jb69/WaveHat/hardware/netlist-revB.md

# WaveHat rev B: netlist

Generated by `kicad-revB/gen_docs.py` from `kicad-revB/wavehat_design.py`, the same file the schematic and PCB are built from. Don't edit by hand.

Pin numbers: LSM6DSO from ST AN5192; TPS560430 from TI SLVSE22B; XIAO pads 1-14 from Seeed's OPL KiCad library (identical on the C3, C6 and S3). CAN pins and the 0x6B address follow the Takuma project's XIAO node.

| Net | Class | Connects |
|---|---|---|
| `GND` | pour | C1.2, C2.2, C3.2, C4.2, C5.2, C7.2, C8.2, C9.2, H1.1, H2.1, J2.1 (Pin_1), J3.1 (Pin_1), J4.3 (Pin_3), J5.6 (Pin_6), J6.3 (Pin_3), J6.10 (Pin_10), J7.2 (Pin_2), JP3.3 (B), R4.2, R6.2, TP11.1, TP25.1, TVS1.2 (A), U1.2 (SDx), U1.3 (SCx), U1.6 (GND), U1.7 (GND), U2.2 (GND), U3.2 (GND), U4.13 (GND), U4.16 (GND(C3/S3)), U4.18 (GND(C6)), U5.4 (VSS) |
| `5V_BUCK` | Power | C5.1, D2.2 (A), L1.2, R3.1, TP22.1 |
| `5V_CAN` | Power | D3.2 (A), J3.4 (Pin_4), TP19.1 |
| `SW` | Power | C6.2, L1.1, U2.6 (SW) |
| `VBAT` | Power | J7.1 (Pin_1), U4.15 (VBAT(C3/S3)), U4.17 (VBAT(C6)) |
| `VIN` | Power | C4.1, D1.1 (K), TP21.1, TVS1.1 (K), U2.4 (EN), U2.5 (VIN) |
| `VIN_FUSED` | Power | D1.2 (A), F1.2 |
| `VIN_RAW` | Power | F1.1, J4.2 (Pin_2), TP20.1 |
| `XIAO_5V` | Power | D2.1 (K), D3.1 (K), J5.1 (Pin_1), J6.1 (Pin_1), TP23.1, U4.14 (5V) |
| `3V3` | Supply 0.3 mm | C1.1, C2.1, C3.1, C8.1, C9.1, J2.2 (Pin_2), J6.2 (Pin_2), JP3.1 (A), JP8.1 (A), R1.1, R10.1, R11.1, R12.1, R2.1, R9.1, TP26.1, TP8.1, U1.5 (VDDIO), U1.8 (VDD), U1.12 (CS), U4.12 (3V3), U5.8 (VCC) |
| `3V3_CAN` | Supply 0.3 mm | C7.1, JP8.2 (B), U3.3 (VCC) |
| `CANH` | signal | J3.3 (Pin_3), J4.4 (Pin_4), R5.1, TP14.1, U3.7 (CANH) |
| `CANL` | signal | J3.2 (Pin_2), J4.5 (Pin_5), JP6.2 (B), TP15.1, U3.6 (CANL) |
| `CAN_RX` | signal | J6.8 (Pin_8), JP9.1 (A), TP17.1, U4.1 (D0) |
| `CAN_RXD` | signal | JP9.2 (B), U3.4 (R) |
| `CAN_TX` | signal | J6.9 (Pin_9), JP10.1 (A), TP16.1, U4.2 (D1) |
| `CAN_TXD` | signal | JP10.2 (B), U3.1 (D) |
| `CB` | signal | C6.1, TP24.1, U2.1 (CB) |
| `FB` | signal | R3.2, R4.1, U2.3 (FB) |
| `IMU_INT1` | signal | JP4.1 (A), TP9.1, U1.4 (INT1) |
| `IMU_INT2` | signal | JP5.1 (A), TP10.1, U1.9 (INT2) |
| `LED_B` | signal | J6.5 (Pin_5), JP5.2 (B), JP7.1 (A), TP2.1, U4.4 (D3) |
| `LED_R` | signal | J6.4 (Pin_4), JP4.2 (B), TP1.1, U4.3 (D2) |
| `RS` | signal | R6.1, U3.8 (Rs) |
| `SA0` | signal | JP3.2 (C), TP7.1, U1.1 (SDO/SA0) |
| `SCL` | signal | J2.4 (Pin_4), J5.4 (Pin_4), JP2.1 (A), TP4.1, U1.13 (SCL), U4.6 (D5/SCL) |
| `SCL_PU` | signal | JP2.2 (B), R2.2, TP6.1 |
| `SDA` | signal | J2.3 (Pin_3), J5.5 (Pin_5), JP1.1 (A), TP3.1, U1.14 (SDA), U4.5 (D4/SDA) |
| `SDA_PU` | signal | JP1.2 (B), R1.2, TP5.1 |
| `SD_CS` | signal | JP7.2 (B), R9.2, TP27.1, U5.2 (~{CS}) |
| `SD_MISO` | signal | R11.2, TP29.1, U4.10 (D9), U5.6 (DO) |
| `SD_MOSI` | signal | R12.2, TP30.1, U4.11 (D10), U5.5 (DI) |
| `SD_SCK` | signal | R10.2, TP28.1, U4.9 (D8), U5.3 (SCLK) |
| `TERM` | signal | JP6.1 (A), R5.2, TP18.1 |
| `UART_RX` | signal | J5.3 (Pin_3), J6.7 (Pin_7), TP13.1, U4.8 (D7/RX) |
| `UART_TX` | signal | J5.2 (Pin_2), J6.6 (Pin_6), TP12.1, U4.7 (D6/TX) |

**No connect:** J4.1 (Pin_1), U1.10 (OCS_Aux), U1.11 (SDO_Aux), U3.5 (Vref), U5.1 (RSV), U5.7 (RSV)

**Mechanical:** connector MP tabs unconnected; H1/H2 on GND; FID1-3 no net.

**Bottom side, bare copper (not assembled):** JP1-JP10 solder jumpers (JP8-JP10 isolate the CAN transceiver: cut all three for a build with no CAN), TP1-TP30 test pads (`kicad-revB/reports/test-pads.md`), J4 NMEA 2000 / 5-30 V pads. **DNP:** J5 GNSS port, J7 battery holes (U4 pads 15-18 are the carrier pads under the XIAO's own battery pads).
