jb69/WaveHat/hardware/netlist.md

# WaveHat rev A: netlist

Generated by `kicad/gen_docs.py` from `kicad/wavehat_design.py`, the same file the schematic and PCB are built from. Don't edit by hand.

Pin numbers: LSM6DSO from ST AN5192; TPS560430 from TI SLVSE22B; XIAO pads 1-14 from Seeed's OPL KiCad library (identical on the C3, C6 and S3). CAN pins and the 0x6B address follow the Takuma project's XIAO node.

| Net | Class | Connects |
|---|---|---|
| `GND` | pour | C1.2, C2.2, C3.2, C4.2, C5.2, C7.2, C8.2, C9.2, H1.1, H2.1, J2.1 (Pin_1), J3.1 (Pin_1), J4.3 (Pin_3), JP3.3 (B), R4.2, R6.2, TVS1.2 (A), U1.2 (SDx), U1.3 (SCx), U1.6 (GND), U1.7 (GND), U2.2 (GND), U3.2 (GND), U4.13 (GND), U5.4 (VSS) |
| `5V_BUCK` | Power | C5.1, D2.2 (A), L1.2, R3.1 |
| `5V_CAN` | Power | D3.2 (A), J3.4 (Pin_4) |
| `SW` | Power | C6.2, L1.1, U2.6 (SW) |
| `VIN` | Power | C4.1, D1.1 (K), TVS1.1 (K), U2.4 (EN), U2.5 (VIN) |
| `VIN_FUSED` | Power | D1.2 (A), F1.2 |
| `VIN_RAW` | Power | F1.1, J4.2 (Pin_2) |
| `XIAO_5V` | Power | D2.1 (K), D3.1 (K), U4.14 (5V) |
| `3V3` | signal | C1.1, C2.1, C3.1, C7.1, C8.1, C9.1, J2.2 (Pin_2), JP3.1 (A), R1.1, R10.1, R11.1, R12.1, R2.1, R9.1, U1.5 (VDDIO), U1.8 (VDD), U1.12 (CS), U3.3 (VCC), U4.12 (3V3), U5.8 (VCC) |
| `CANH` | signal | J3.3 (Pin_3), J4.4 (Pin_4), R5.1, U3.7 (CANH) |
| `CANL` | signal | J3.2 (Pin_2), J4.5 (Pin_5), JP6.2 (B), U3.6 (CANL) |
| `CAN_RX` | signal | U3.4 (R), U4.1 (D0) |
| `CAN_TX` | signal | U3.1 (D), U4.2 (D1) |
| `CB` | signal | C6.1, U2.1 (CB) |
| `FB` | signal | R3.2, R4.1, U2.3 (FB) |
| `IMU_INT1` | signal | JP4.1 (A), U1.4 (INT1) |
| `IMU_INT2` | signal | JP5.1 (A), U1.9 (INT2) |
| `LED_B` | signal | JP5.2 (B), JP7.1 (A), TP2.1, U4.4 (D3) |
| `LED_R` | signal | JP4.2 (B), TP1.1, U4.3 (D2) |
| `RS` | signal | R6.1, U3.8 (Rs) |
| `SA0` | signal | JP3.2 (C), U1.1 (SDO/SA0) |
| `SCL` | signal | J2.4 (Pin_4), JP2.1 (A), U1.13 (SCL), U4.6 (D5/SCL) |
| `SCL_PU` | signal | JP2.2 (B), R2.2 |
| `SDA` | signal | J2.3 (Pin_3), JP1.1 (A), U1.14 (SDA), U4.5 (D4/SDA) |
| `SDA_PU` | signal | JP1.2 (B), R1.2 |
| `SD_CS` | signal | JP7.2 (B), R9.2, U5.2 (~{CS}) |
| `SD_MISO` | signal | R11.2, U4.10 (D9), U5.6 (DO) |
| `SD_MOSI` | signal | R12.2, U4.11 (D10), U5.5 (DI) |
| `SD_SCK` | signal | R10.2, U4.9 (D8), U5.3 (SCLK) |
| `TERM` | signal | JP6.1 (A), R5.2 |

**No connect:** J4.1 (Pin_1), U1.10 (OCS_Aux), U1.11 (SDO_Aux), U3.5 (Vref), U4.7 (D6/TX), U4.8 (D7/RX), U5.1 (RSV), U5.7 (RSV)

**Mechanical:** connector MP tabs unconnected; H1/H2 on GND; FID1-3 no net.

**Bottom side, bare copper (not assembled):** JP1-JP6 solder jumpers, TP1-TP3 test pads, J4 NMEA 2000 / 12 V pads.
