jb69/WaveHat/hardware/kicad-revB/reports/vias.md

# Vias in rev B

Generated by `gen_pcb.py import`. 102 signal and power vias from the router, 43 of them twinned (a second via 0.8-2.0 mm away, linked on both layers); 59 found no room and stay single, so those crossings are the ones to meter first (`reports/test-pads.md` has the pads). GND stitching vias are not listed. Coordinates: mm from the board's lower-left corner, component side up, the Gerber origin.

| Net | Vias (x, y) | Twins | Single |
|---|---|---|---|
| 3V3 | (4.11, 6.91), (4.46, 44.26), (11.49, 67.13), (12.60, 64.82), (14.55, 57.30) | 3 | (14.55, 57.30), (4.46, 44.26) |
| 3V3_CAN | (7.71, 49.24) | 1 | - |
| 5V_BUCK | (5.86, 20.52), (17.65, 24.96) | 1 | (5.86, 20.52) |
| 5V_CAN | (13.90, 24.91), (17.10, 56.84) | 1 | (17.10, 56.84) |
| CANH | (7.50, 52.26), (7.72, 38.03), (8.14, 39.90), (9.87, 48.72), (12.89, 39.68) | 1 | (8.14, 39.90), (12.89, 39.68), (7.50, 52.26), (9.87, 48.72) |
| CANL | (5.07, 41.10), (5.20, 29.78), (5.24, 44.17), (6.33, 30.70), (11.49, 48.63) | 1 | (5.20, 29.78), (5.07, 41.10), (5.24, 44.17), (11.49, 48.63) |
| CAN_RX | (7.79, 45.30), (8.03, 24.74) | 1 | (7.79, 45.30) |
| CAN_RXD | (12.41, 47.16) | 1 | - |
| CAN_TX | (7.04, 43.76), (10.99, 30.19), (11.75, 25.38), (12.51, 33.98) | 1 | (7.04, 43.76), (10.99, 30.19), (12.51, 33.98) |
| CAN_TXD | (7.82, 44.53) | 0 | (7.82, 44.53) |
| CB | (4.44, 18.71) | 0 | (4.44, 18.71) |
| FB | (12.86, 30.27), (15.68, 31.74) | 0 | (12.86, 30.27), (15.68, 31.74) |
| IMU_INT1 | (8.14, 61.94), (9.34, 64.20), (13.09, 52.01), (13.26, 57.59), (13.55, 50.15) | 2 | (13.55, 50.15), (13.26, 57.59), (13.09, 52.01) |
| IMU_INT2 | (15.59, 60.27), (15.59, 62.99), (17.54, 58.24), (17.87, 48.40), (17.92, 44.24), (20.17, 64.15) | 4 | (15.59, 60.27), (17.87, 48.40) |
| LED_B | (4.20, 19.76), (6.42, 52.11), (8.92, 51.89), (14.27, 37.89), (14.49, 41.52), (16.33, 23.07), (17.08, 11.79) | 3 | (4.20, 19.76), (16.33, 23.07), (14.49, 41.52), (8.92, 51.89) |
| LED_R | (7.05, 42.99), (15.54, 38.45), (15.76, 24.58), (17.32, 31.04) | 0 | (7.05, 42.99), (15.76, 24.58), (17.32, 31.04), (15.54, 38.45) |
| RS | (10.49, 39.16), (12.19, 39.17) | 0 | (12.19, 39.17), (10.49, 39.16) |
| SA0 | (8.60, 67.03), (15.04, 65.34), (15.21, 58.86) | 3 | - |
| SCL | (2.15, 57.01), (4.08, 37.75), (4.76, 60.11), (10.50, 67.30), (16.96, 19.60), (19.67, 58.24) | 3 | (10.50, 67.30), (19.67, 58.24), (4.08, 37.75) |
| SCL_PU | (12.51, 59.69) | 0 | (12.51, 59.69) |
| SDA | (3.89, 38.80), (7.47, 40.36), (9.43, 67.06), (15.13, 39.12), (16.86, 40.06), (17.61, 40.94) | 3 | (9.43, 67.06), (3.89, 38.80), (15.13, 39.12) |
| SDA_PU | (1.49, 50.36), (5.35, 57.97), (10.60, 62.99) | 1 | (10.60, 62.99), (5.35, 57.97) |
| SD_MISO | (4.72, 10.93) | 0 | (4.72, 10.93) |
| SD_MOSI | (4.77, 8.16) | 0 | (4.77, 8.16) |
| SD_SCK | (4.28, 14.24), (5.87, 7.64), (5.87, 14.24) | 1 | (5.87, 7.64), (5.87, 14.24) |
| TERM | (9.74, 38.70), (9.74, 43.16), (12.52, 35.75), (13.72, 39.58), (14.84, 32.49) | 2 | (13.72, 39.58), (12.52, 35.75), (9.74, 43.16) |
| UART_RX | (1.80, 40.51), (2.04, 21.47), (2.85, 35.85), (3.77, 54.73), (14.10, 53.26), (14.25, 54.92) | 2 | (14.25, 54.92), (14.10, 53.26), (1.80, 40.51), (3.77, 54.73) |
| UART_TX | (9.06, 53.03), (14.65, 51.56), (17.16, 55.34) | 1 | (9.06, 53.03), (17.16, 55.34) |
| VBAT | (14.33, 19.95) | 1 | - |
| VIN | (2.04, 26.15), (8.40, 31.03), (13.74, 26.04) | 3 | - |
| VIN_RAW | (2.65, 29.78), (2.91, 32.01) | 1 | (2.91, 32.01) |
| XIAO_5V | (3.15, 24.80), (6.54, 19.57), (9.90, 20.70) | 2 | (6.54, 19.57) |

Rev A's open vias were 3V3 to the NAND island and LED_B (SD CS); both nets are twinned here where the router left room, and both have a test pad (TP26 and TP2).
