jb69/WaveHat/enclosure/base.png

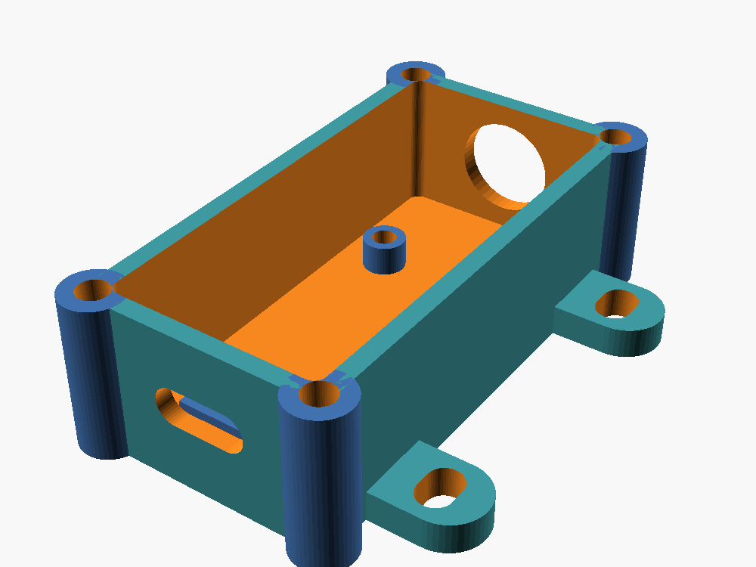
enclosure/base.png
