jb69/WaveHat/hardware/kicad-revB/img/wavehat-3d-bottom.png

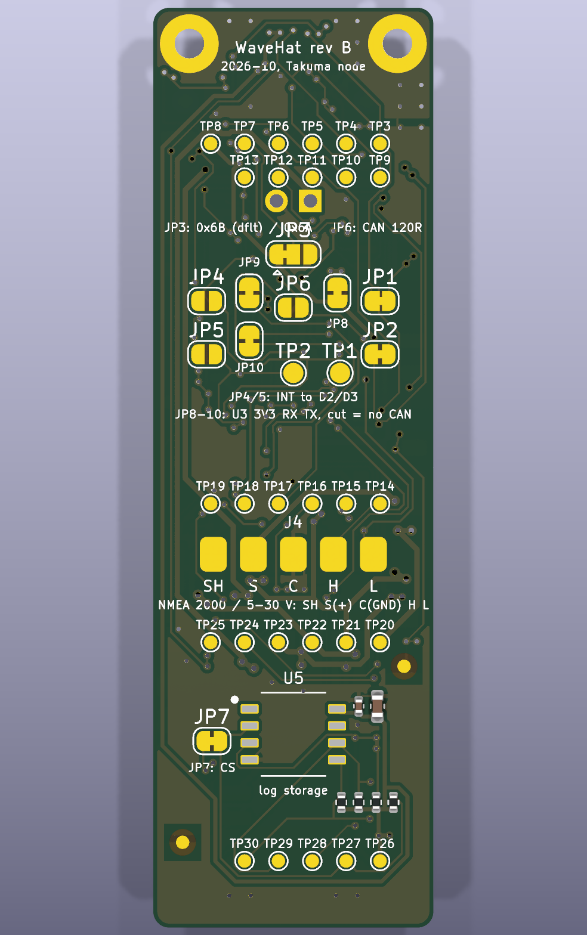
hardware/kicad-revB/img/wavehat-3d-bottom.png
