jb69/WaveHat/hardware/kicad-revB/img/wavehat-3d-top.png

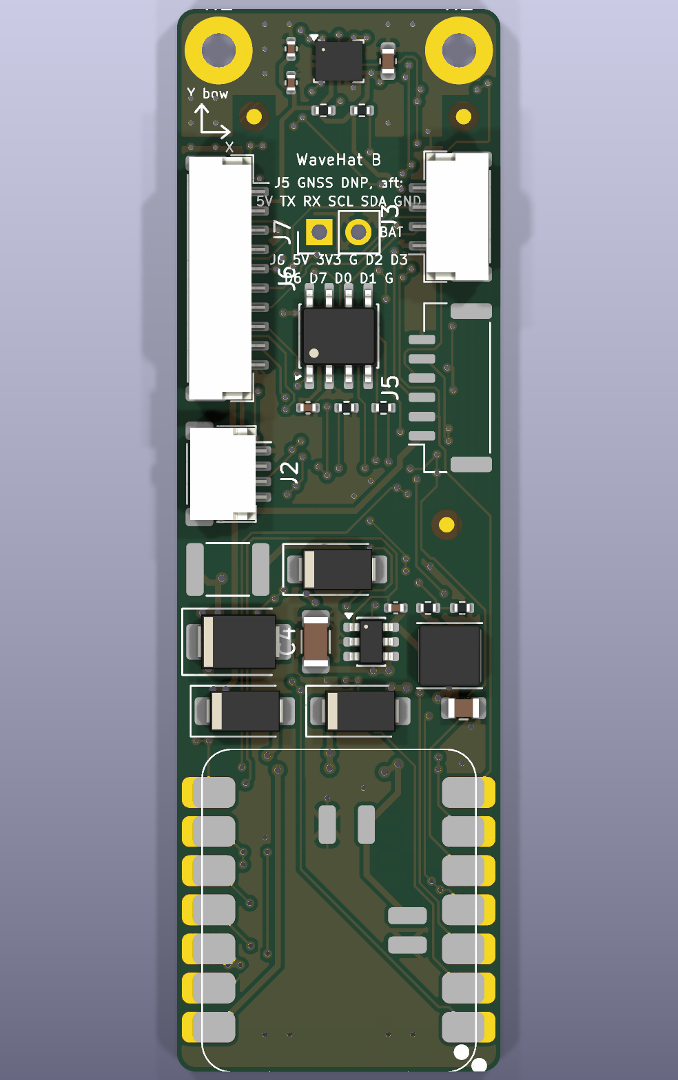
hardware/kicad-revB/img/wavehat-3d-top.png
