jb69/WaveHat/hardware/bom-revB.csv

Designator | Value | Footprint | MPN | Qty | DNP
C1,C3,C6,C7,C8 | 100nF | Capacitor_SMD:C_0402_1005Metric | GRM155R71C104KA88D | 5
C2,C9 | 10uF | Capacitor_SMD:C_0603_1608Metric | GRM188R61A106KE69D | 2
C4 | 2.2uF 100V | Capacitor_SMD:C_1206_3216Metric | GRM31CR72A225KA73L | 1
C5 | 22uF 10V | Capacitor_SMD:C_0805_2012Metric | GRM21BR61A226ME51L | 1
D1,D2,D3 | SS14 | Diode_SMD:D_SMA | SS14 | 3
F1 | 0.5A 60V | Fuse:Fuse_1812_4532Metric | 1812L050/60MR | 1
J2 | Qwiic | Connector_JST:JST_SH_SM04B-SRSS-TB_1x04-1MP_P1.00mm_Horizontal | SM04B-SRSS-TB(LF)(SN) | 1
J3 | VESC CAN | Connector_JST:JST_GH_SM04B-GHS-TB_1x04-1MP_P1.25mm_Horizontal | SM04B-GHS-TB(LF)(SN) | 1
J5 | GNSS (Pixhawk GPS port) | Connector_JST:JST_GH_SM06B-GHS-TB_1x06-1MP_P1.25mm_Horizontal | SM06B-GHS-TB(LF)(SN) | 1 | DNP
J6 | IO header | Connector_JST:JST_GH_SM10B-GHS-TB_1x10-1MP_P1.25mm_Horizontal | SM10B-GHS-TB(LF)(SN) | 1
J7 | BAT 1S LiPo (+ pin 1) | Connector_PinHeader_2.54mm:PinHeader_1x02_P2.54mm_Vertical |  | 1 | DNP
L1 | 15uH | Inductor_SMD:L_Changjiang_FNR4020S | FNR4020S150MT | 1
R1,R2 | 4.7k | Resistor_SMD:R_0402_1005Metric | RC0402FR-074K7L | 2
R3 | 120k | Resistor_SMD:R_0402_1005Metric | RC0402FR-07120KL | 1
R4 | 22.1k | Resistor_SMD:R_0402_1005Metric | RC0402FR-0722K1L | 1
R5 | 120 | Resistor_SMD:R_0402_1005Metric | RC0402FR-07120RL | 1
R6,R9,R10,R11,R12 | 10k | Resistor_SMD:R_0402_1005Metric | RC0402FR-0710KL | 5
TVS1 | SMBJ30A | Diode_SMD:D_SMB | SMBJ30A | 1
U1 | LSM6DSO | Package_LGA:LGA-14_3x2.5mm_P0.5mm_LayoutBorder3x4y | LSM6DSOTR | 1
U2 | LMR51606Y | Package_TO_SOT_SMD:SOT-23-6 | LMR51606YDBVR | 1
U3 | SN65HVD230 | Package_SO:SOIC-8_3.9x4.9mm_P1.27mm | SN65HVD230DR | 1
U4 | XIAO ESP32-C3/C6/S3 | wavehat:XIAO_ESP32_14P_SMD | Seeed XIAO ESP32C3 113991054 (or C6 113991254 / S3 113991114) | 1
U5 | SD NAND 2Gb (256 MB) | wavehat:SD_NAND_LGA-8_8x6mm_P1.27mm | ZDSD02GLGEAG | 1
