jb69/WaveHat/enclosure/wavehat_gasket.stl

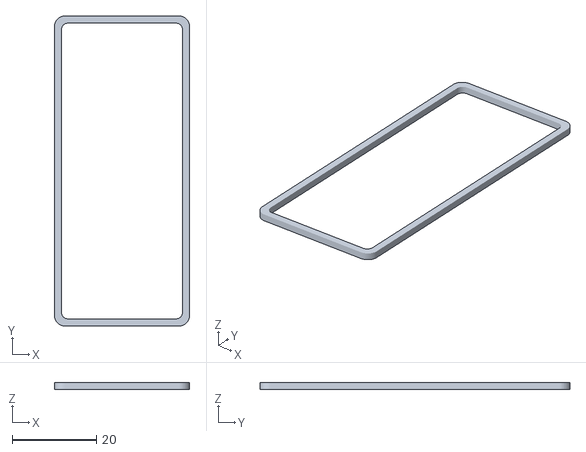
[picture p10: CAD file, 2026-11-09]
enclosure/wavehat_gasket.stl
32.1 x 73.6 x 1.60
