jb69/WaveHat/hardware/test-plate/dual/wavehat_test_plate_plate_text.stl

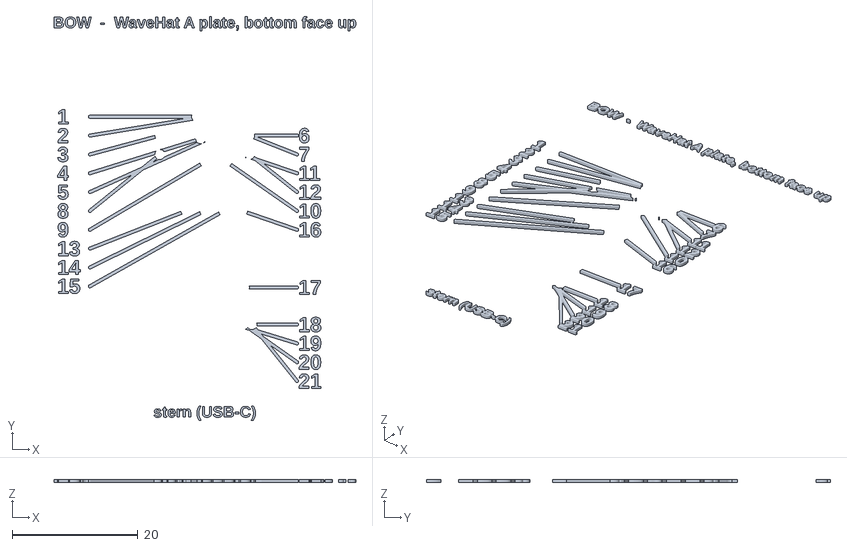
[picture p11: CAD file, 2026-11-09]
hardware/test-plate/dual/wavehat_test_plate_plate_text.stl
48.1 x 64.3 x 0.5
