jb69/WaveHat/hardware/test-plate/wavehat_test_plate_plate.stl

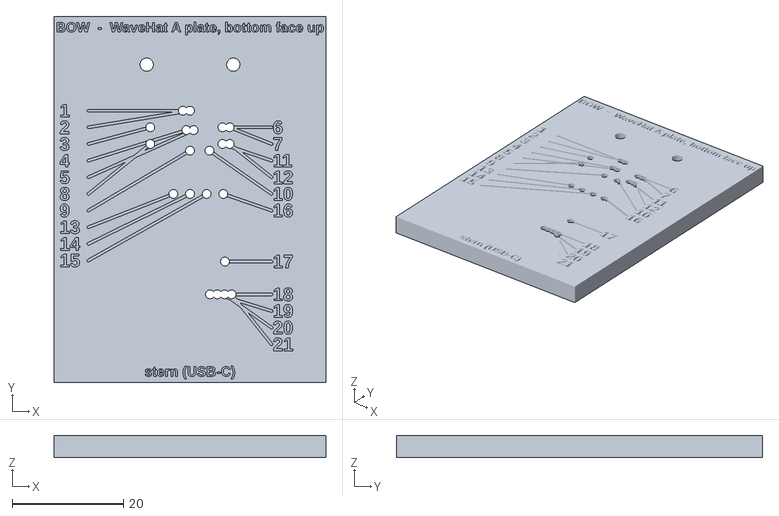
[picture p12: CAD file, 2026-11-09]
hardware/test-plate/wavehat_test_plate_plate.stl
49.0 x 66.0 x 4.00
