jb69/WaveHat/enclosure/wavehat_lid.stl

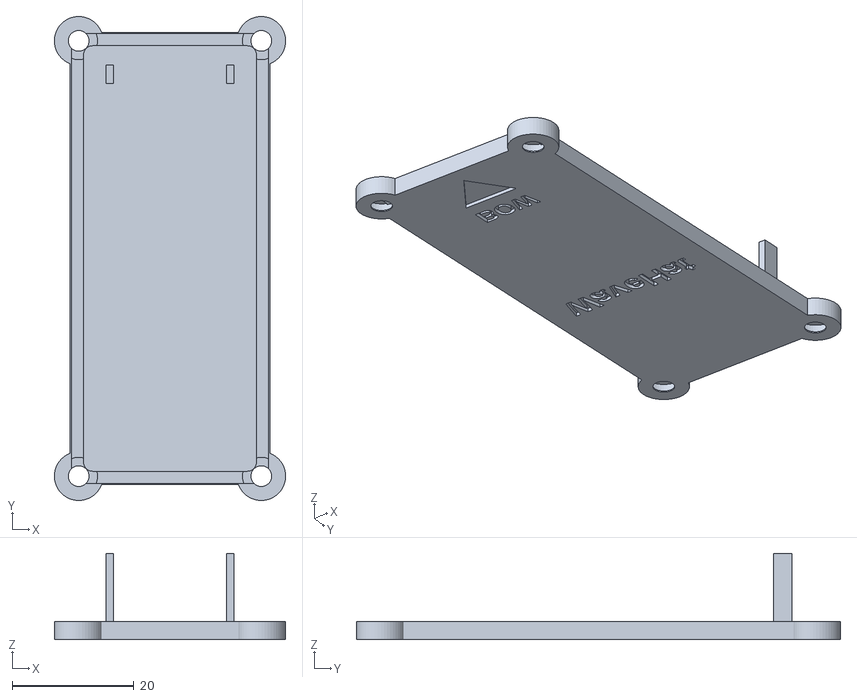
[picture p13: CAD file, 2026-11-09]
enclosure/wavehat_lid.stl
38.0 x 79.5 x 14.2
