jb69/WaveHat/hardware/test-plate/dual/wavehat_test_plate_base_text.stl

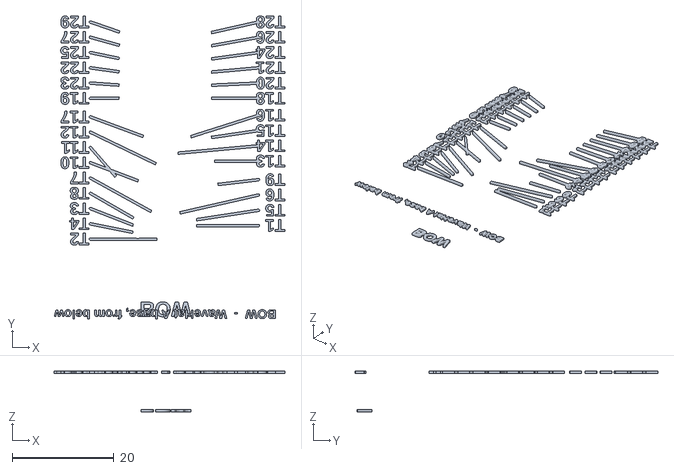
[picture p14: CAD file, 2026-11-09]
hardware/test-plate/dual/wavehat_test_plate_base_text.stl
45.3 x 59.5 x 8.00
