jb69/WaveHat/hardware/test-plate/wavehat_test_plate_base.stl

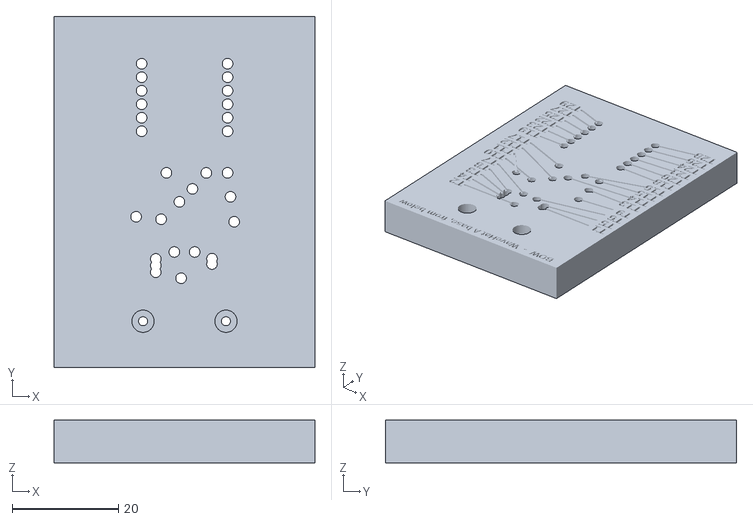
[picture p15: CAD file, 2026-11-09]
hardware/test-plate/wavehat_test_plate_base.stl
49.0 x 66.0 x 8.00
