jb69/WaveHat/enclosure/wavehat_usb_plug.stl

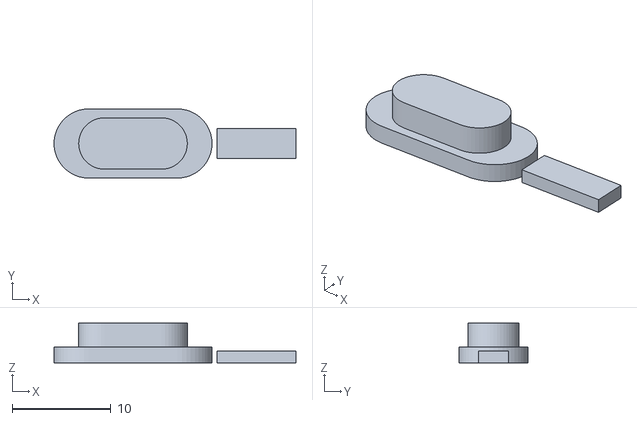
[picture p16: CAD file, 2026-11-09]
enclosure/wavehat_usb_plug.stl
24.5 x 7.00 x 4.00
