jb69/WaveHat/enclosure/wavehat_base.stl

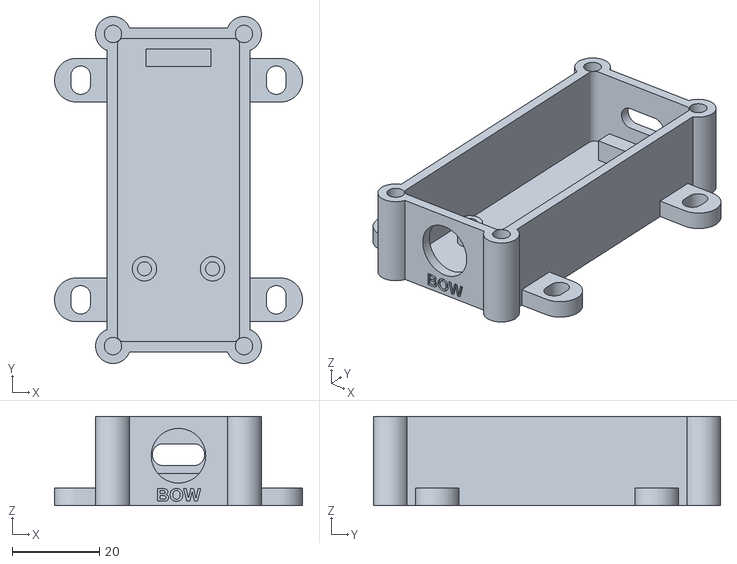
[picture p17: CAD file, 2026-11-09]
enclosure/wavehat_base.stl
56.8 x 79.5 x 20.4
