jb69/WaveHat/hardware/test-plate/dual/wavehat_test_plate_base_body.3mf

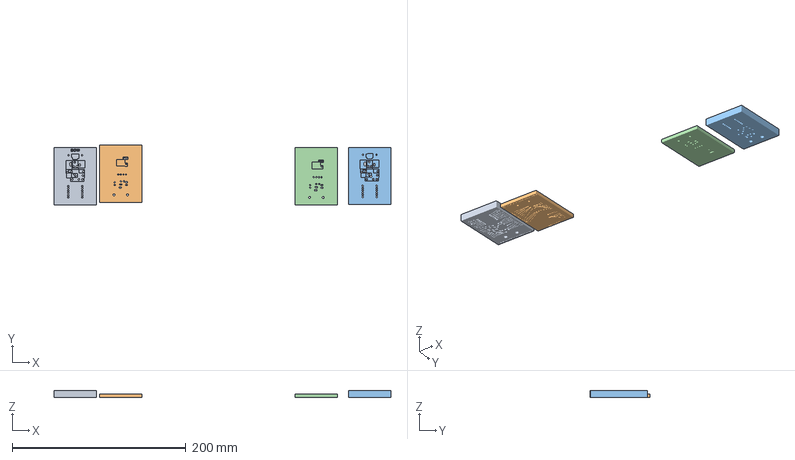
[picture p18: CAD file, 2026-11-09]
hardware/test-plate/dual/wavehat_test_plate_base_body.3mf
387.6 x 69.1 x 8.00 mm
wavehat_test_plate_base.stl
wavehat_test_plate_plate.stl
wavehat_test_plate_base_body
wavehat_test_plate_plate_body
