jb69/WaveHat/hardware/test-plate/test_plate_points.scad

// Generated by gen_test_plate.py from ../kicad/wavehat.kicad_pcb. mm from the board's lower-left corner.
board = [21.0, 54.0];
mount_holes = [[2.70, 51.30], [18.30, 51.30]];  // symmetric in x
// Plate holes, bottom view: [x, y, number, label side (0 left, 1 right), label y]
points = [
  [  9.20,  43.00,  1, 0,  43.00],  // 3V3 (JP3): JP3 pad 1
  [ 10.50,  43.00,  2, 0,  40.00],  // SA0: JP3 pad 2
  [  3.35,  40.00,  3, 0,  37.00],  // IMU_INT1: JP4 pad 1
  [  9.85,  39.50,  4, 0,  34.00],  // TERM: JP6 pad 1
  [ 11.15,  39.50,  5, 0,  31.00],  // CANL (JP6): JP6 pad 2
  [ 16.35,  40.00,  6, 1,  40.00],  // SDA: JP1 pad 1
  [ 17.65,  40.00,  7, 1,  37.00],  // SDA_PU: JP1 pad 2
  [  3.35,  37.00,  8, 0,  28.00],  // IMU_INT2: JP5 pad 1
  [ 10.50,  35.80,  9, 0,  25.00],  // LED_B (D3, NAND CS): TP2 pad 1
  [ 14.00,  35.80, 10, 1,  28.00],  // LED_R (D2): TP1 pad 1
  [ 16.35,  37.00, 11, 1,  34.00],  // SCL: JP2 pad 1
  [ 17.65,  37.00, 12, 1,  31.00],  // SCL_PU: JP2 pad 2
  [  7.50,  28.00, 13, 0,  22.00],  // VIN_RAW: J4 pad 2
  [ 10.50,  28.00, 14, 0,  19.00],  // GND: J4 pad 3
  [ 13.50,  28.00, 15, 0,  16.00],  // CANH: J4 pad 4
  [ 16.50,  28.00, 16, 1,  25.00],  // CANL: J4 pad 5
  [ 16.80,  15.82, 17, 1,  15.82],  // 3V3 (NAND island): C9 pad 1
  [ 14.10,   9.91, 18, 1,   9.91],  // SD_MOSI (D10): R12 pad 2
  [ 15.40,   9.91, 19, 1,   6.91],  // SD_MISO (D9): R11 pad 2
  [ 16.70,   9.91, 20, 1,   3.91],  // SD_SCK (D8): R10 pad 2
  [ 18.00,   9.91, 21, 1,   0.91],  // SD_CS (D3 through JP7): R9 pad 2
];
// Base holes, TOP view (the .scad mirrors x): [x, y, number, label side, label y]
base_points = [
  [  5.33,  40.55,  1, 0,  40.55],  // T1 SDA, J2 tail: J2 pad 3
  [ 11.14,  43.22,  2, 1,  43.22],  // T2 CANL, transceiver: U3 pad 6
  [ 15.90,  40.83,  3, 1,  37.22],  // T3 CANH, J3 tail: J3 pad 3
  [ 15.90,  42.08,  4, 1,  40.22],  // T4 5V_CAN, J3 tail: J3 pad 4
  [  5.33,  39.55,  5, 0,  37.55],  // T5 SCL, J2 tail: J2 pad 4
  [  8.59,  38.28,  6, 0,  34.55],  // T6 CAN_TX, transceiver TXD: U3 pad 1
  [ 12.41,  38.28,  7, 1,  31.22],  // T7 CAN_RX, transceiver RXD: U3 pad 4
  [ 15.90,  39.58,  8, 1,  34.22],  // T8 CANL, J3 tail: J3 pad 2
  [  1.16,  32.60,  9, 0,  31.55],  // T9 VIN_RAW, fuse: F1 pad 1
  [ 14.90,  32.12, 10, 1,  28.22],  // T10 CB, bootstrap: C6 pad 1
  [ 19.60,  31.65, 11, 1,  25.22],  // T11 5V_BUCK, buck output: C5 pad 1
  [ 11.46,  28.85, 12, 1,  22.22],  // T12 CB, buck BST: U2 pad 1
  [  1.85,  27.90, 13, 0,  27.90],  // T13 VIN, TVS: TVS1 pad 1
  [  9.00,  26.42, 14, 0,  24.90],  // T14 VIN, input capacitor: C4 pad 1
  [  2.40,  23.40, 15, 0,  21.90],  // T15 XIAO_5V, D2 anode: D2 pad 1
  [  6.40,  23.40, 16, 0,  18.90],  // T16 5V_BUCK, D2 cathode: D2 pad 2
  [ 13.90,  23.40, 17, 1,  19.22],  // T17 5V_CAN, D3 cathode: D3 pad 2
  [  2.40,  15.58, 18, 0,  15.58],  // T18 SD_SCK, XIAO D8: U4 pad 9
  [ 18.56,  15.58, 19, 1,  15.58],  // T19 SCL, XIAO D5: U4 pad 6
  [  2.40,  13.04, 20, 0,  12.58],  // T20 SD_MISO, XIAO D9: U4 pad 10
  [  2.40,  10.50, 21, 0,   9.58],  // T21 SD_MOSI, XIAO D10: U4 pad 11
  [ 18.56,  10.50, 22, 1,   9.58],  // T22 LED_B, XIAO D3: U4 pad 4
  [ 18.56,  13.04, 23, 1,  12.58],  // T23 SDA, XIAO D4: U4 pad 5
  [  2.40,   7.96, 24, 0,   6.58],  // T24 3V3, XIAO 3V3: U4 pad 12
  [ 18.56,   7.96, 25, 1,   6.58],  // T25 LED_R, XIAO D2: U4 pad 3
  [  2.40,   5.42, 26, 0,   3.58],  // T26 GND, XIAO GND: U4 pad 13
  [ 18.56,   5.42, 27, 1,   3.58],  // T27 CAN_TX, XIAO D1: U4 pad 2
  [  2.40,   2.88, 28, 0,   0.58],  // T28 XIAO_5V, XIAO 5V: U4 pad 14
  [ 18.56,   2.88, 29, 1,   0.58],  // T29 CAN_RX, XIAO D0: U4 pad 1
];
// Plate underside pockets over the bottom-side parts (bottom view): [x1, y1, x2, y2, depth]
plate_pockets = [
  [ 14.42,  15.16,  16.39,  18.03,  1.1],  // C8
  [ 15.55,  14.59,  18.06,  18.60,  1.4],  // C9
  [ 15.70,   7.94,  17.69,  10.85,  1.1],  // R10
  [ 14.41,   7.94,  16.39,  10.85,  1.1],  // R11
  [ 13.11,   7.94,  15.09,  10.85,  1.1],  // R12
  [ 17.00,   7.94,  19.00,  10.85,  1.1],  // R9
  [  5.30,  10.72,  15.28,  18.28,  1.5],  // U5
];
// Base top pockets over the component-side parts (bottom view): [x1, y1, x2, y2, depth]
base_pockets = [
  [ 12.61,  49.97,  14.58,  52.83,  1.1],  // C1
  [  6.05,  48.59,   8.56,  52.61,  1.4],  // C2
  [ 12.61,  47.77,  14.58,  50.64,  1.1],  // C3
  [ 10.33,  25.07,  13.67,  30.72,  2.3],  // C4
  [ -0.11,  30.38,   2.91,  34.83,  1.9],  // C5
  [  5.11,  31.17,   7.08,  34.03,  1.1],  // C6
  [ 11.06,  35.11,  13.94,  37.08,  1.1],  // C7
  [  6.58,  30.33,  14.67,  34.88,  3.0],  // D1
  [ 12.58,  21.12,  20.67,  25.68,  3.0],  // D2
  [  5.08,  21.12,  13.17,  25.68,  3.0],  // D3
  [ 14.22,  30.12,  21.17,  35.08,  2.1],  // F1
  [ 13.86,  36.62,  21.47,  45.47,  3.4],  // J2
  [ -0.47,  34.94,   6.97,  45.45,  4.8],  // J3
  [  0.47,  25.12,   6.12,  30.67,  2.6],  // L1
  [ 10.05,  46.41,  12.95,  48.39,  1.1],  // R1
  [  7.55,  46.41,  10.45,  48.39,  1.1],  // R2
  [  3.70,  31.14,   5.69,  34.06,  1.1],  // R3
  [  2.41,  31.14,   4.39,  34.06,  1.1],  // R4
  [  6.14,  35.11,   9.06,  37.09,  1.1],  // R5
  [  8.55,  35.11,  11.45,  37.09,  1.1],  // R6
  [ 12.83,  25.12,  21.22,  30.67,  3.1],  // TVS1
  [  8.22,  48.58,  12.91,  52.85,  1.4],  // U1
  [  5.83,  25.67,  10.97,  30.30,  1.9],  // U2
  [  7.28,  36.53,  13.86,  44.97,  2.2],  // U3
];
