jb69/WaveHat/hardware/test-plate/render_base_print.png

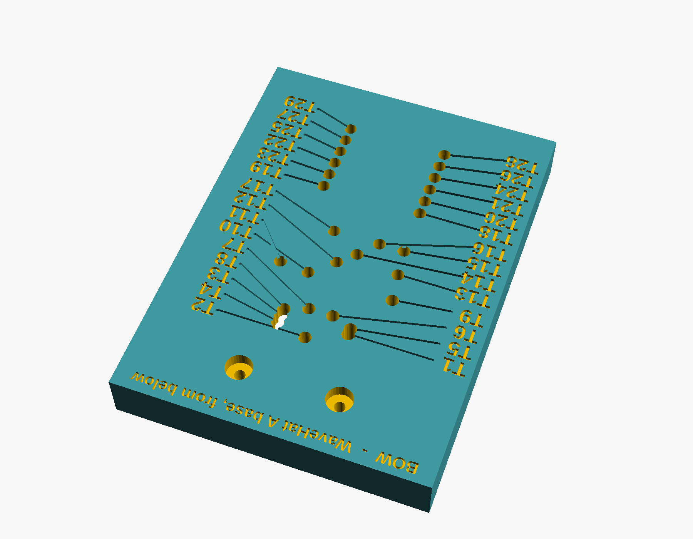
hardware/test-plate/render_base_print.png
