jb69/WaveHat/hardware/kicad-revB/reports/test-pads.md

# WaveHat rev B test pads

Generated by `gen_docs.py` from `wavehat_design.py`. All on the **bottom** side, 1.0 mm round (TP1, TP2 1.5 mm), numbered on the silkscreen as TPn. Positions are mm from the board's lower-left corner **seen from the component side** (the Gerber and pick-and-place origin); the bottom-view x, as you look at the pads, is 21 minus that.

Each pad is on a net that crosses between layers, so a reading from the pad to its component-side partner proves that net's vias (twinned in rev B). TP22, TP23 and TP8 also let the power stage run from a bench supply before a XIAO is fitted: feed 12 V between J4 pad 2 and pad 3, expect about 5.1 V on TP22, 4.7 V on TP23, and 3V3 on TP8 only once a XIAO is on.

| Pad | Net | x | y | Partner on the component side | Purpose |
|---|---|---|---|---|---|
| TP1 | LED_R | 7.00 | 41.60 | U4.3 (XIAO D2) | XIAO D2 / INT1 option |
| TP2 | LED_B | 10.50 | 41.60 | U4.4 (XIAO D3) | XIAO D3 / SD CS through JP7 |
| TP3 | SDA | 4.00 | 58.80 | U4.5 (XIAO D4) or J2.3 | I2C data (IMU, J2, J5) |
| TP4 | SCL | 6.54 | 58.80 | U4.6 (XIAO D5) or J2.4 | I2C clock |
| TP5 | SDA_PU | 9.08 | 58.80 | R1.2 | SDA pull-up side of JP1 |
| TP6 | SCL_PU | 11.62 | 58.80 | R2.2 | SCL pull-up side of JP2 |
| TP7 | SA0 | 14.16 | 58.80 | U1.1 (under the IMU; JP3.2 instead) | IMU address pin (JP3) |
| TP8 | 3V3 | 16.70 | 58.80 | U4.12 (XIAO 3V3) | XIAO 3.3 V rail |
| TP9 | IMU_INT1 | 4.00 | 56.26 | U1.4 (under the IMU; JP4.1 instead) | IMU INT1 (JP4) |
| TP10 | IMU_INT2 | 6.54 | 56.26 | U1.9 (under the IMU; JP5.1 instead) | IMU INT2 (JP5) |
| TP11 | GND | 9.08 | 56.26 | U4.13 (XIAO GND) or H1 | ground reference |
| TP12 | UART_TX | 11.62 | 56.26 | U4.7 (XIAO D6), J5.2 or J6.6 | GNSS UART, XIAO D6 out |
| TP13 | UART_RX | 14.16 | 56.26 | U4.8 (XIAO D7), J5.3 or J6.7 | GNSS UART, XIAO D7 in |
| TP14 | CANH | 4.00 | 31.80 | J3.3 or U3.7 | CAN high |
| TP15 | CANL | 6.54 | 31.80 | J3.2 or U3.6 | CAN low |
| TP16 | CAN_TX | 9.08 | 31.80 | U4.2 (XIAO D1), J6.9 or U3.1 (through JP10) | transceiver TXD from XIAO D1 |
| TP17 | CAN_RX | 11.62 | 31.80 | U4.1 (XIAO D0), J6.8 or U3.4 (through JP9) | transceiver RXD to XIAO D0 |
| TP18 | TERM | 14.16 | 31.80 | R5.2 | 120 R side of JP6 |
| TP19 | 5V_CAN | 16.70 | 31.80 | J3.4 or D3.2 | 5 V out to J3 |
| TP20 | VIN_RAW | 4.00 | 21.40 | F1.1 | input before the fuse |
| TP21 | VIN | 6.54 | 21.40 | C4.1 or TVS1.1 | input after fuse and reverse diode |
| TP22 | 5V_BUCK | 9.08 | 21.40 | C5.1 or D2.2 | buck output, before D2 |
| TP23 | XIAO_5V | 11.62 | 21.40 | U4.14 (XIAO 5V) or D2.1 | XIAO 5V pin rail |
| TP24 | CB | 14.16 | 21.40 | C6.1 or U2.1 | buck bootstrap |
| TP25 | GND | 16.70 | 21.40 | U4.13 (XIAO GND) or H1 | ground reference |
| TP26 | 3V3 | 4.00 | 5.00 | U4.12 (XIAO 3V3) | 3V3 on the SD NAND island (rev A board 2's open via) |
| TP27 | SD_CS | 6.54 | 5.00 | JP7.2 (bottom) / R9.2 | SD NAND chip select |
| TP28 | SD_SCK | 9.08 | 5.00 | U4.9 (XIAO D8) | SD NAND clock |
| TP29 | SD_MISO | 11.62 | 5.00 | U4.10 (XIAO D9) | SD NAND data out |
| TP30 | SD_MOSI | 14.16 | 5.00 | U4.11 (XIAO D10) | SD NAND data in |

Rows, bottom view with the bow away from you: TP3-TP8 and TP9-TP13 behind the sensor zone, TP14-TP19 between the CAN parts and the J4 pads, TP20-TP25 under the power stage, TP26-TP30 behind the SD NAND under the XIAO. TP1 and TP2 are the rev A pads by the INT jumpers.
