jb69/WaveHat/firmware/desktop/results/results.csv

hs_nom | tp_nom | gamma | roll | pitch | seed | method | hs_true | hs_band | tp_true | tz_true | tz_band | heave_rms_true | hs | tp | tz | heave_rms | heave_rms_td | segments | periods_valid | peak_ratio | hs_err | tp_err | tz_err | tz_band_err | heave_td_err
0.3000 | 3 | 3.3000 | 5.0000 | 2.0000 | 1 | calibrated | 0.3000 | 0.2788 | 3 | 2.4593 | 2.8045 | 0.0765 | 0.2866 | 2.9800 | 2.8198 | 0.0716 | 0.0766 | 14 | 1 | 8.5760 | -4.4778 | -0.6659 | 14.6589 | 0.5447 | 0.2051
0.3000 | 3 | 3.3000 | 5.0000 | 2.0000 | 1 | uncalibrated | 0.3000 | 0.2788 | 3 | 2.4593 | 2.8045 | 0.0765 | 0.2841 | 2.9797 | 2.8185 | 0.0710 | 0.0764 | 14 | 1 | 8.6456 | -5.2935 | -0.6777 | 14.6081 | 0.5002 | -0.0960
0.3000 | 3 | 3.3000 | 5.0000 | 2.0000 | 1 | ideal sensor | 0.3000 | 0.2788 | 3 | 2.4593 | 2.8045 | 0.0765 | 0.2871 | 2.9802 | 2.8198 | 0.0718 | 0.0767 | 14 | 1 | 8.5780 | -4.3060 | -0.6610 | 14.6619 | 0.5474 | 0.2552
0.3000 | 3 | 3.3000 | 5.0000 | 2.0000 | 1 | no tilt correction | 0.3000 | 0.2788 | 3 | 2.4593 | 2.8045 | 0.0765 | 0.5179 | 22.5055 | 4.9592 | 0.1295 | 0.4485 | 14 | 0 | 70.3649 | 72.6180 | 650.1832 | 101.6528 | 76.8300 | 486.5010
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
