jb69/WaveHat/hardware/test-plate/dual/render_dual.png

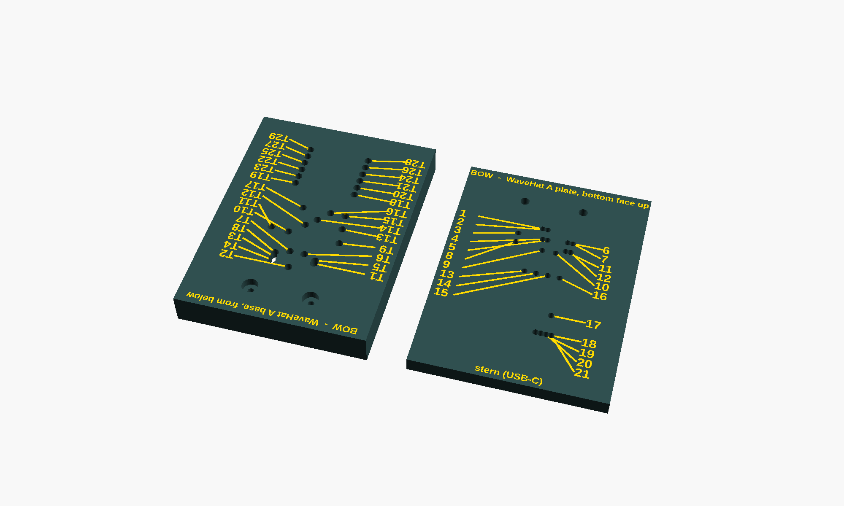
hardware/test-plate/dual/render_dual.png
