jb69/WaveHat/hardware/test-plate/render_plate_top.png

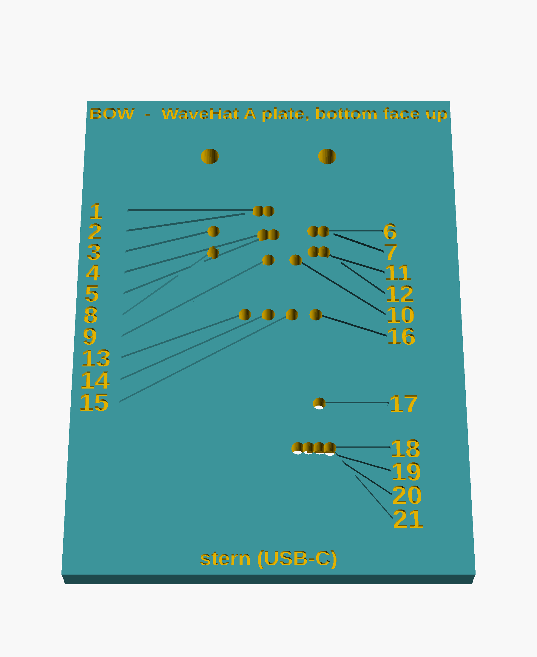
hardware/test-plate/render_plate_top.png
