jb69/WaveHat/hardware/kicad-revB/wavehat-schematic.pdf

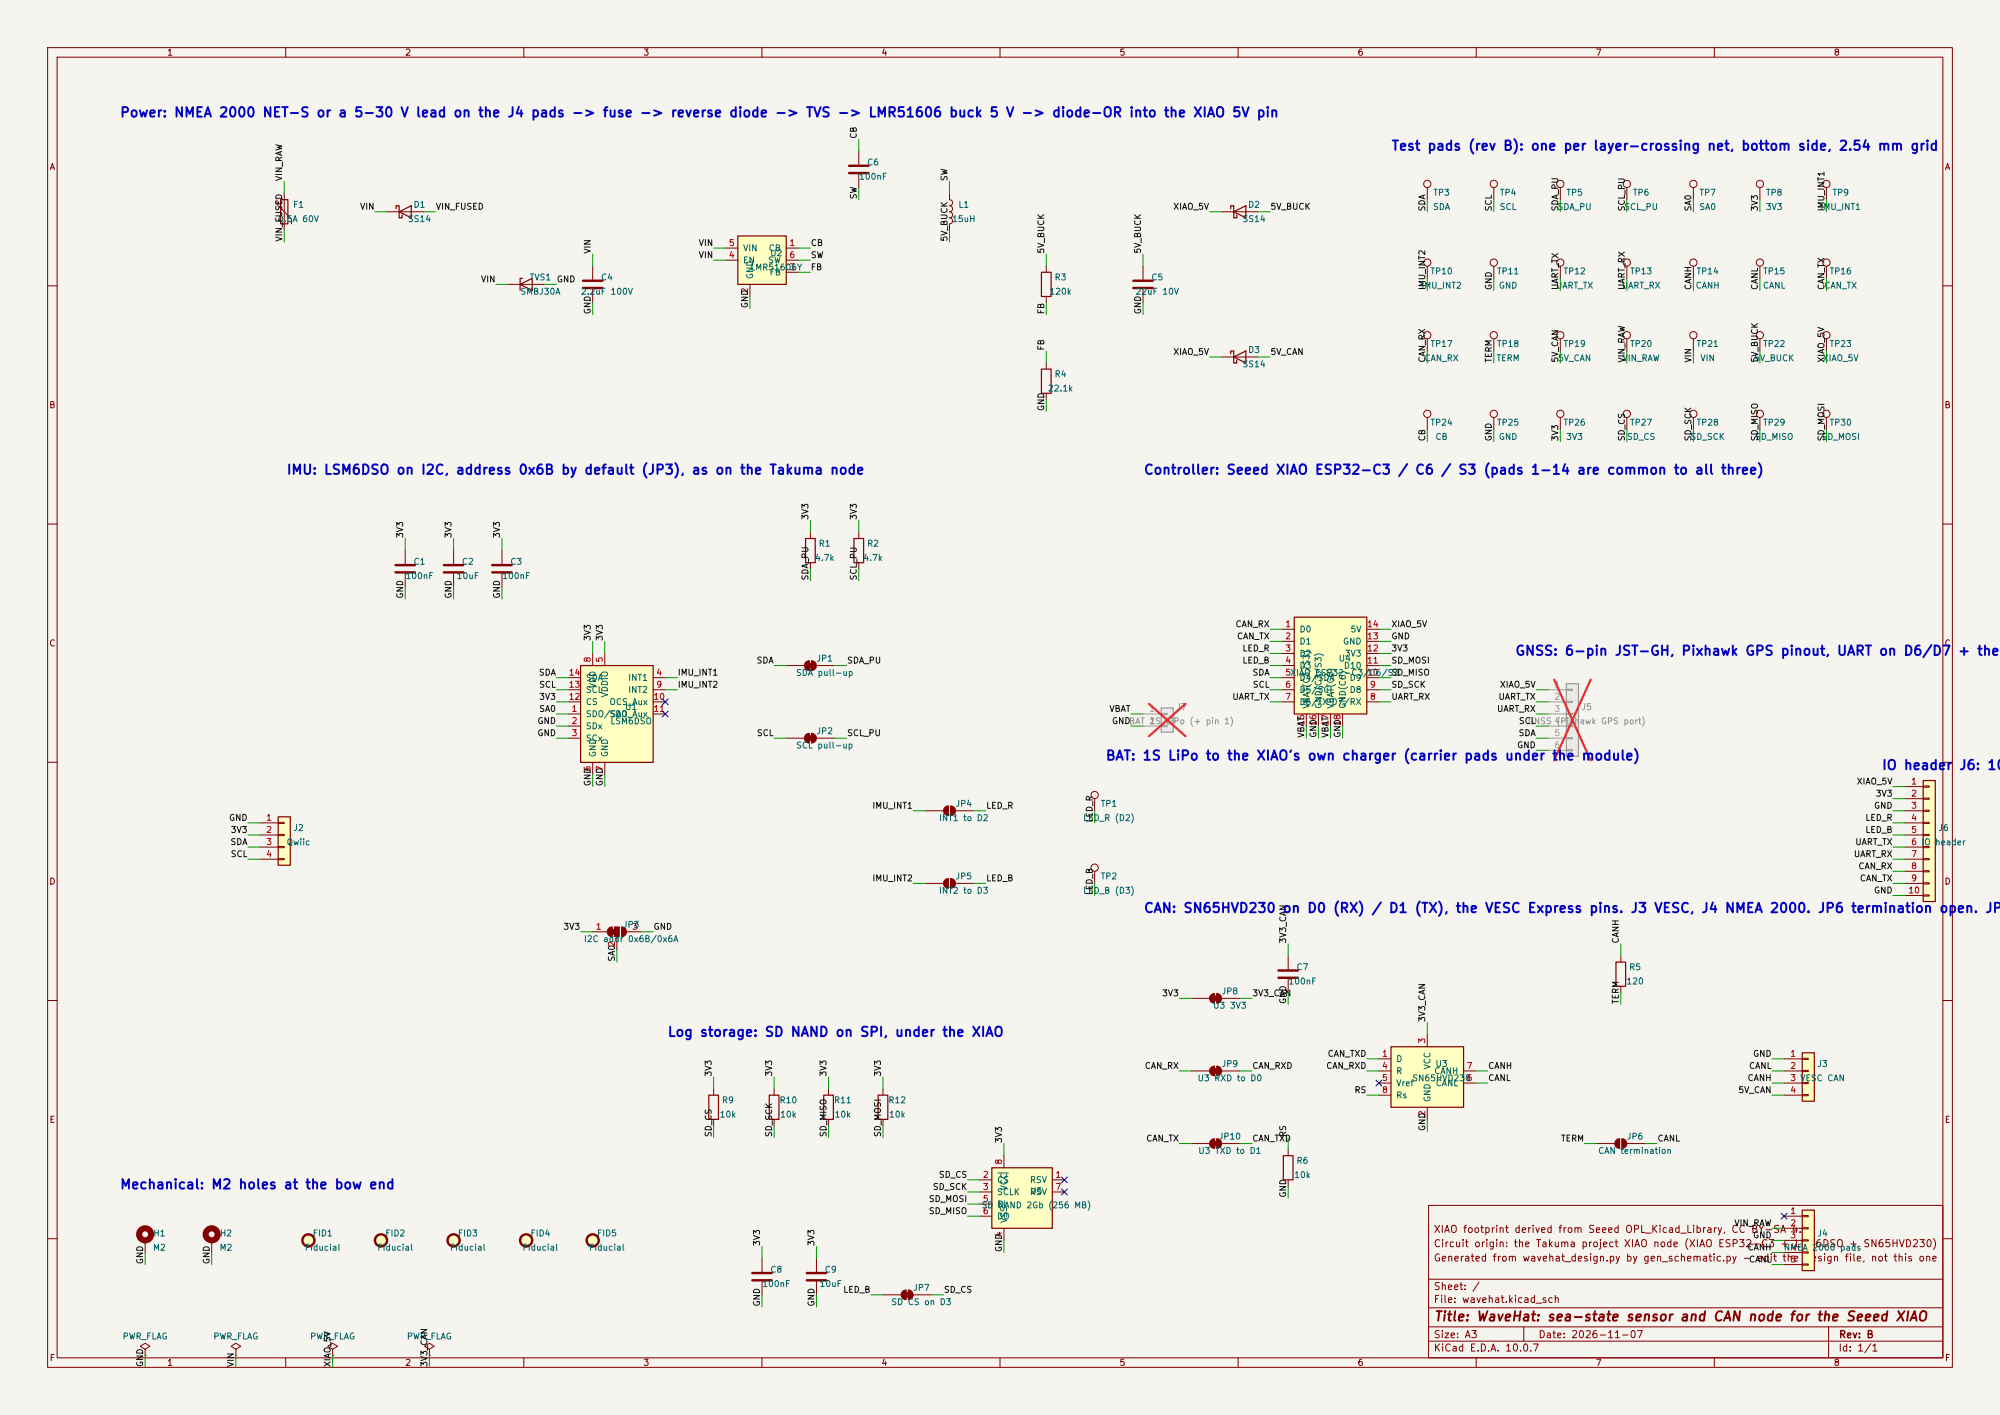
[picture p24: page 1]

Power: NMEA 2000 NET-S or a 5-30 V lead on the J4 pads -> fuse -> reverse diode -> TVS -> LMR51606 buck 5 V -> diode-OR into the XIAO 5V pin
VIN_FUSED XIAO_5V GND

Test pads (rev B): one per layer-crossing net, bottom side, 2.54 mm grid

IMU: LSM6DSO on I2C, address 0x6B by default (JP3), as on the Takuma node

Controller: Seeed XIAO ESP32-C3 / C6 / S3 (pads 1-14 are common to all three)

GNSS: 6-pin JST-GH, Pixhawk GPS pinout, UART on D6/D7 + the I2C bus. DNP: fit by hand where wanted

J5 GNSS (Pixhawk GPS port) PWR_FLAG

GND Log storage: SD NAND on SPI, under the XIAO

IO header J6: 10-pin JST-GH, the spare pins on a lead (D0/D1 free once JP8-10 are cut)

CAN: SN65HVD230 on D0 (RX) / D1 (TX), the VESC Express pins. J3 VESC, J4 NMEA 2000. JP6 termination open. JP8/9/10 bridged: cut all three for a build with no CAN

4 DI 5 DO 6 RSV VCC
SD NAND 2Gb (256 MB)

Mechanical: M2 holes at the bow end

XIAO footprint derived from Seeed OPL_Kicad_Library, CC BY-SA 4.0

Sheet: /
File: wavehat.kicad_sch
Title: WaveHat: sea-state sensor and CAN node for the Seeed XIAO

Size: A3 | Rev: B | F Date: 2026-11-07
KiCad E.D.A. 10.0.7 | Id: 1/1
