jb69/WaveHat/hardware/kicad/wavehat-schematic.pdf

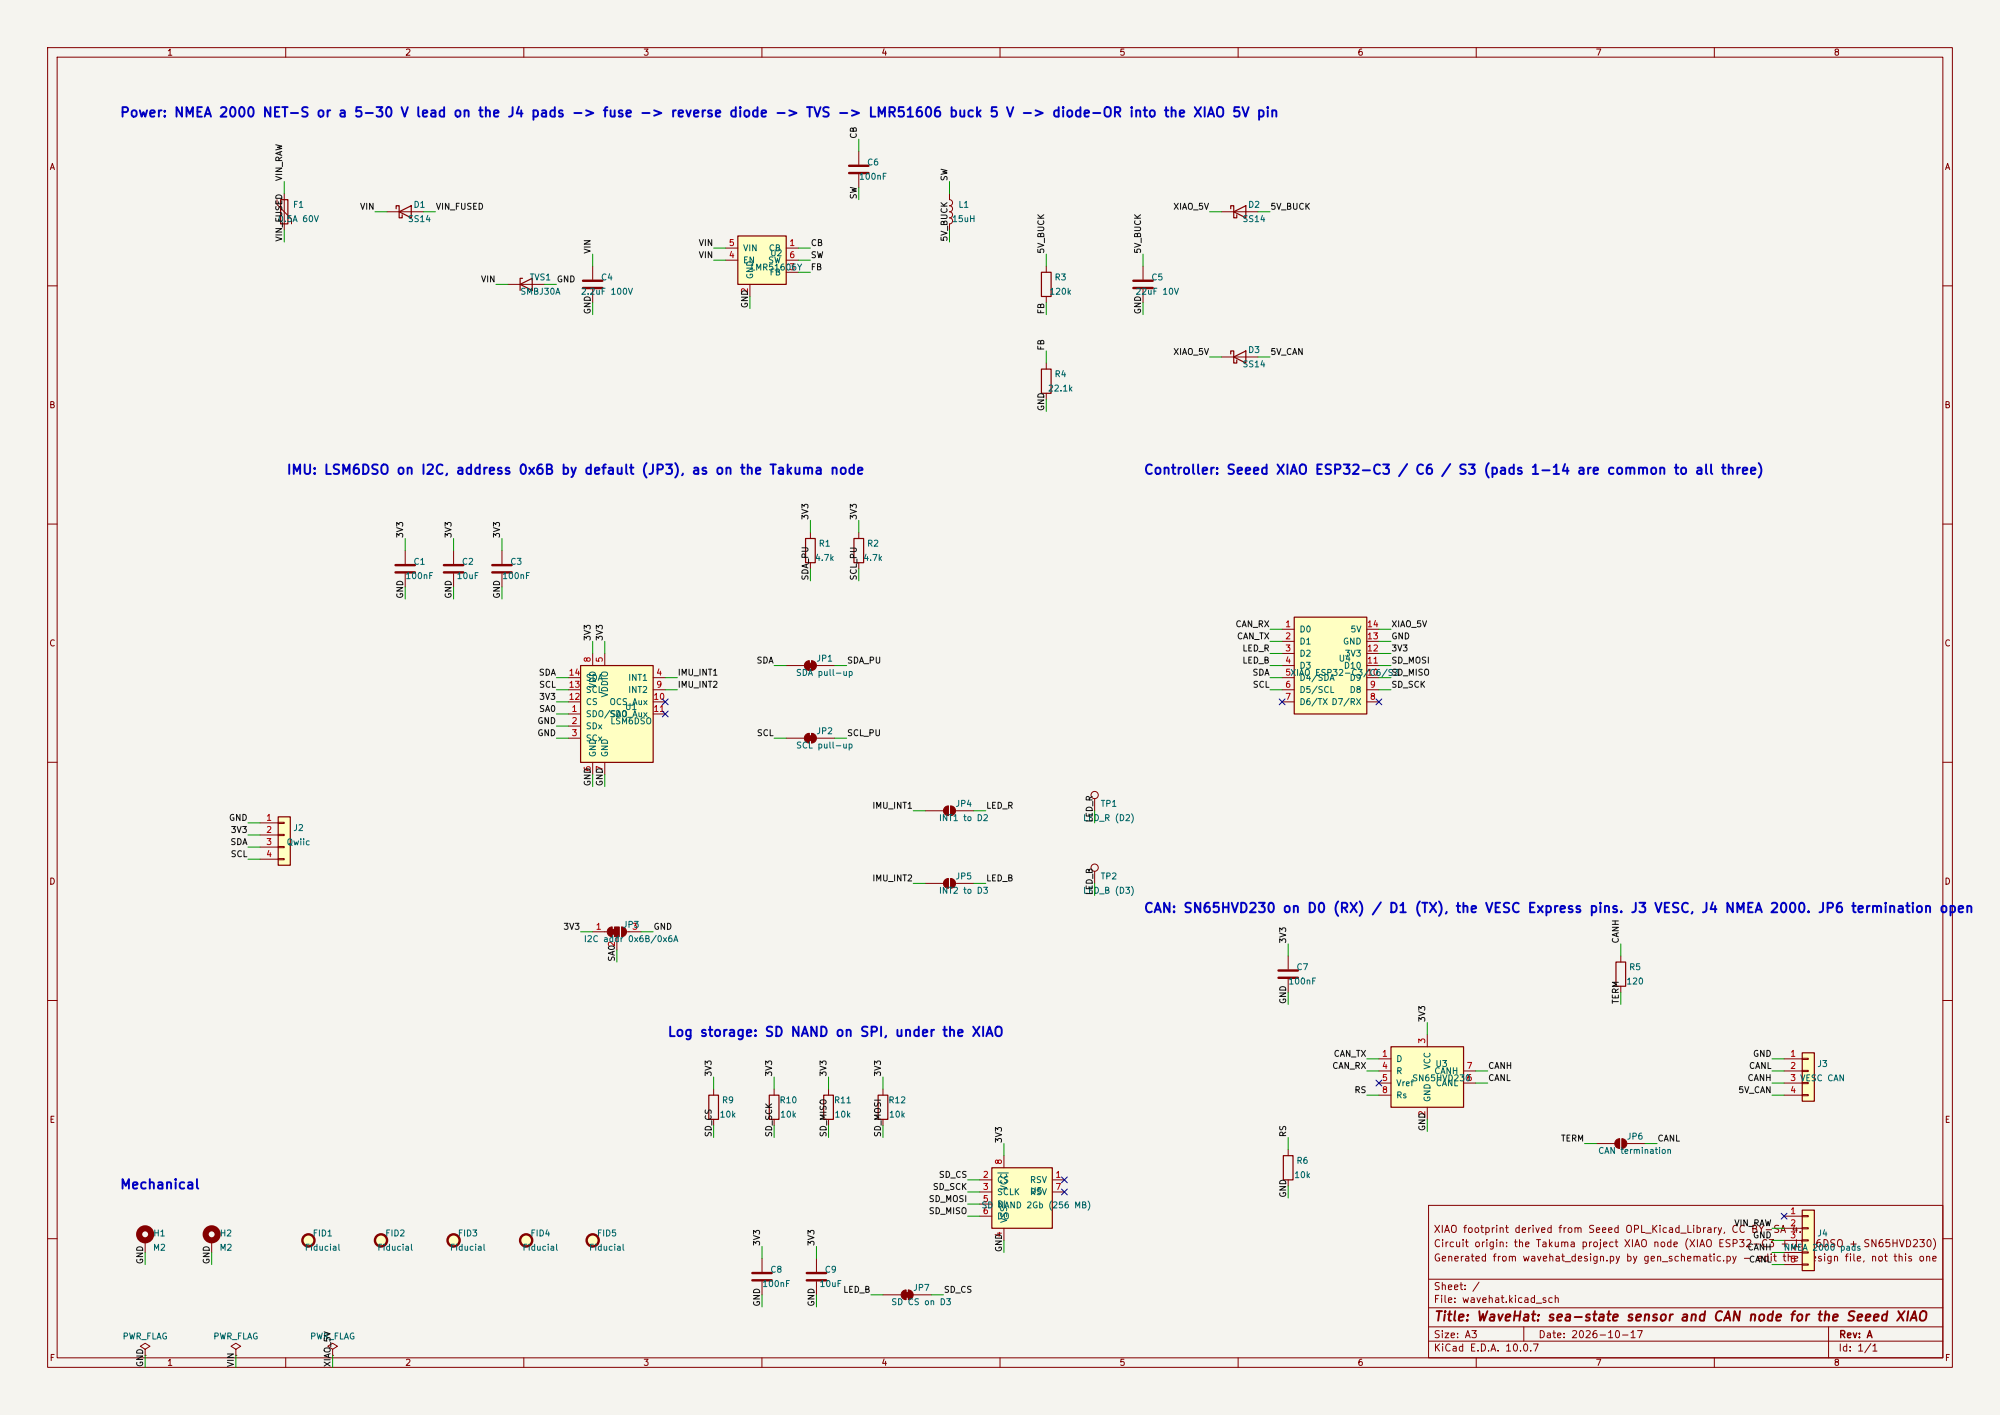
[picture p25: page 1]
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

IMU: LSM6DSO on I2C, address 0x6B by default (JP3), as on the Takuma node

Controller: Seeed XIAO ESP32-C3 / C6 / S3 (pads 1-14 are common to all three)
XIAO ESP32-C3/C6/S3D

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

Log storage: SD NAND on SPI, under the XIAO

4 DI 5 DO 6 RSV VCC

XIAO footprint derived from Seeed OPL_Kicad_Library, CC BY-SA 4.0

Sheet: /
File: wavehat.kicad_sch
Title: WaveHat: sea-state sensor and CAN node for the Seeed XIAO

Size: A3 | Rev: A | F Date: 2026-10-17
KiCad E.D.A. 10.0.7 | Id: 1/1
