jb69/WaveHat/hardware/kicad-revB/fab/seeed/wavehat-assembly-bottom.pdf

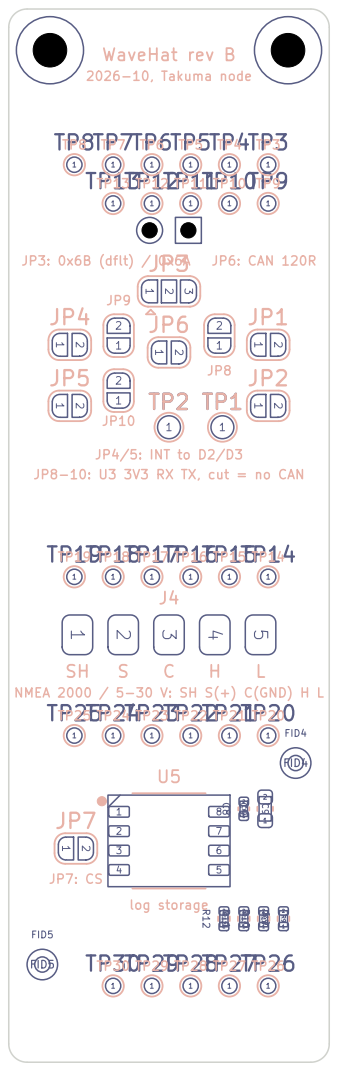
[picture p26: page 1]

JP8-10: U3 3V3 RX TX, cut = no CAN

Generated from wavehat_design.py by gen_pcb.py

Sheet:
File: wavehat.kicad_pcb
Title: WaveHat: sea-state sensor and CAN node for the Seeed XIAO

Size: A4 | Rev: B
KiCad E.D.A. 10.0.7 | Id: 1/1
