jb69/WaveHat/hardware/kicad/fab/seeed/wavehat-assembly-top.pdf

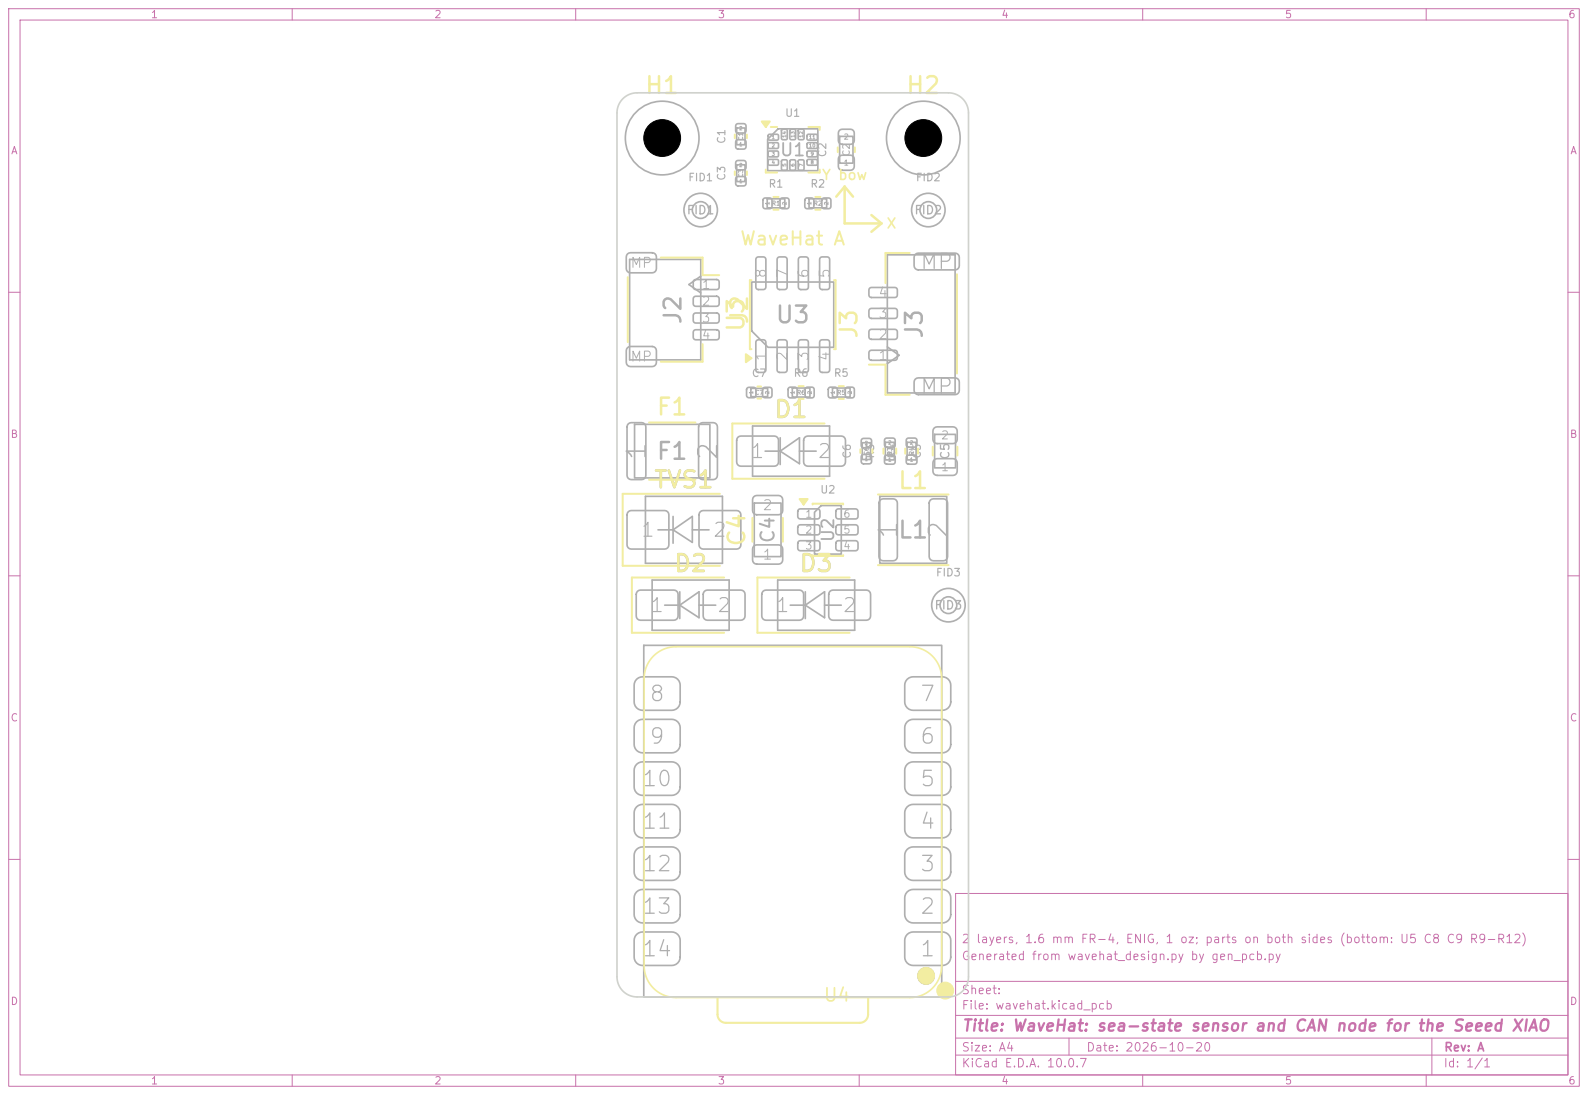
[picture p27: page 1]

2 layers, 1.6 mm FR-4, ENIG, 1 oz; parts on both sides (bottom: U5 C8 C9 R9-R12)

Generated from wavehat_design.py by gen_pcb.py

Sheet:
File: wavehat.kicad_pcb
Title: WaveHat: sea-state sensor and CAN node for the Seeed XIAO

Size: A4 | Rev: A
KiCad E.D.A. 10.0.7 | Id: 1/1
