jb69/WaveHat/hardware/kicad-revB/wavehat.kicad_pcb

## KiCad design hardware/kicad-revB/wavehat.kicad_pcb (2026-11-09)

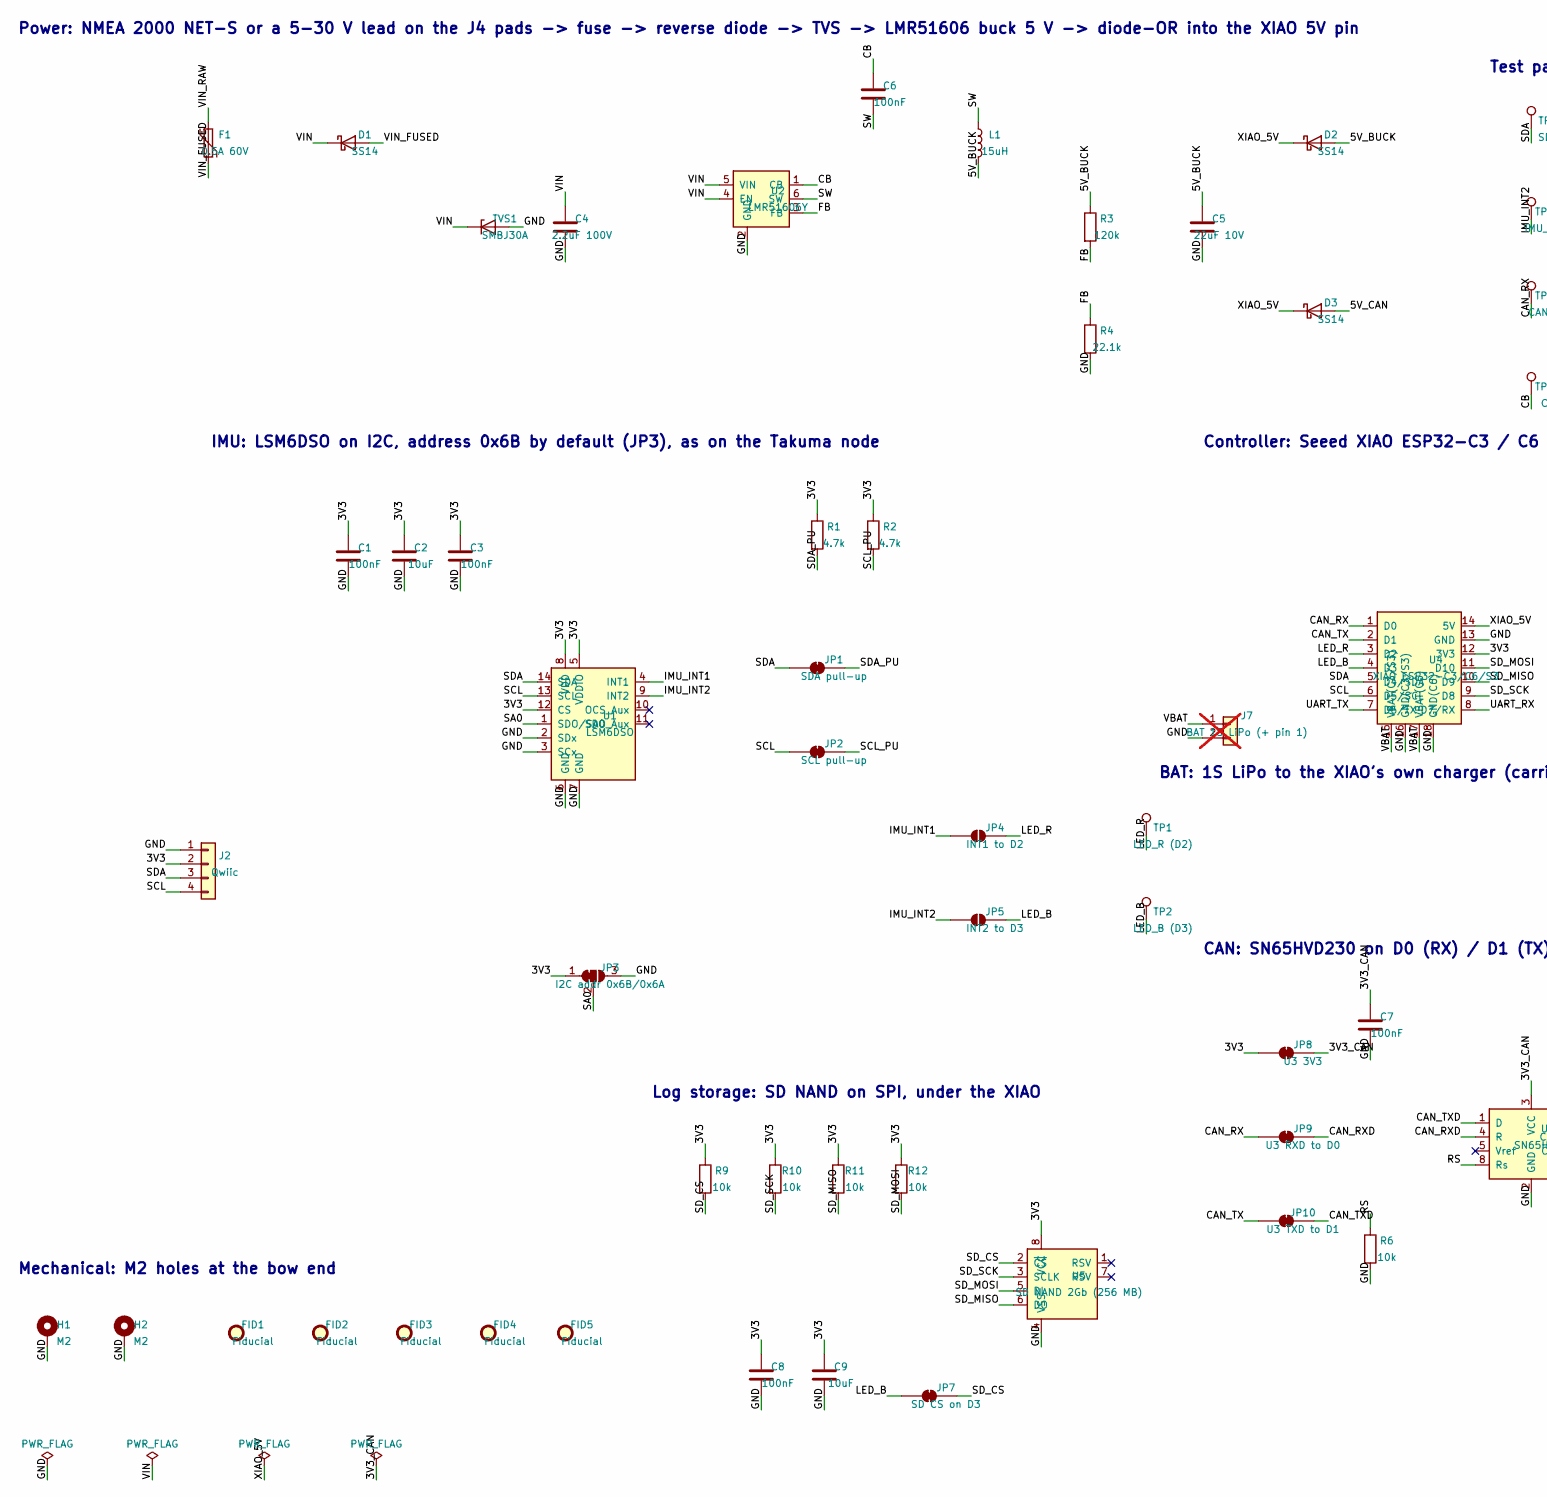
[picture p31: schematic wavehat.kicad_sch, WaveHat: sea-state sensor and CAN node for the Seeed XIAO, part in row 1, column 1]

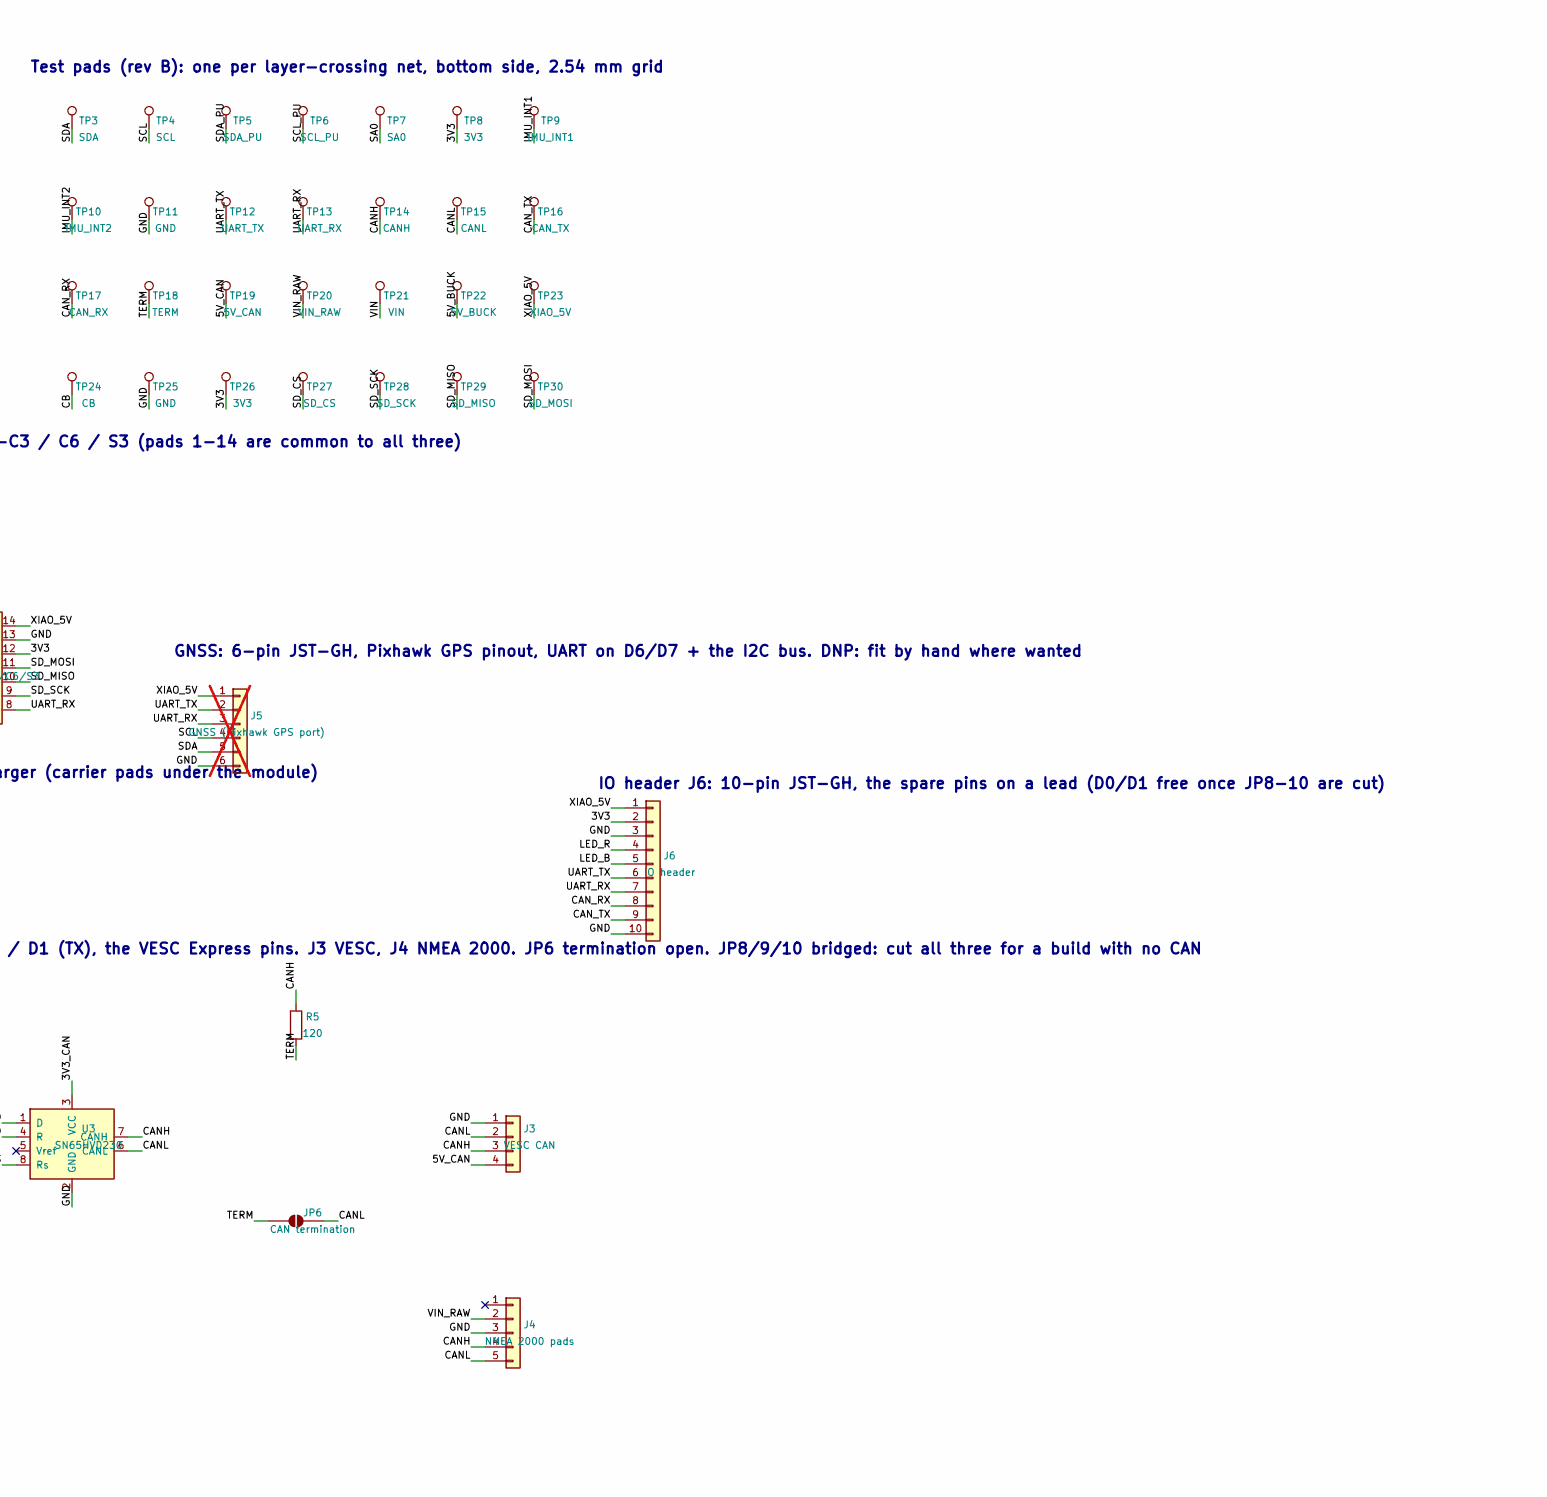
[picture p32: schematic wavehat.kicad_sch, WaveHat: sea-state sensor and CAN node for the Seeed XIAO, part in row 1, column 2]

Parts:
C1, C3, C6, C7, C8: 100nF; C_0402_1005Metric; MPN GRM155R71C104KA88D
C2, C9: 10uF; C_0603_1608Metric; MPN GRM188R61A106KE69D
C4: 2.2uF 100V; C_1206_3216Metric; MPN GRM31CR72A225KA73L
C5: 22uF 10V; C_0805_2012Metric; MPN GRM21BR61A226ME51L
D1, D2, D3: SS14; D_SMA; MPN SS14
F1: 0.5A 60V; Fuse_1812_4532Metric; MPN 1812L050/60MR
FID1, FID2, FID3, FID4, FID5: Fiducial; Fiducial_1mm_Mask2mm
H1, H2: M2; MountingHole_2.2mm_M2_Pad
J2: Qwiic; JST_SH_SM04B-SRSS-TB_1x04-1MP_P1.00mm_Horizontal; MPN SM04B-SRSS-TB(LF)(SN)
J3: VESC CAN; JST_GH_SM04B-GHS-TB_1x04-1MP_P1.25mm_Horizontal; MPN SM04B-GHS-TB(LF)(SN)
J4: NMEA 2000 pads; N2K_Pads_1x05_P3.0mm
J5: GNSS (Pixhawk GPS port); JST_GH_SM06B-GHS-TB_1x06-1MP_P1.25mm_Horizontal; MPN SM06B-GHS-TB(LF)(SN); not fitted
J6: IO header; JST_GH_SM10B-GHS-TB_1x10-1MP_P1.25mm_Horizontal; MPN SM10B-GHS-TB(LF)(SN)
J7: BAT 1S LiPo (+ pin 1); PinHeader_1x02_P2.54mm_Vertical; not fitted
JP1: SDA pull-up; SolderJumper-2_P1.3mm_Bridged_RoundedPad1.0x1.5mm
JP2: SCL pull-up; SolderJumper-2_P1.3mm_Bridged_RoundedPad1.0x1.5mm
JP3: I2C addr 0x6B/0x6A; SolderJumper-3_P1.3mm_Bridged12_RoundedPad1.0x1.5mm
JP4: INT1 to D2; SolderJumper-2_P1.3mm_Open_RoundedPad1.0x1.5mm
JP5: INT2 to D3; SolderJumper-2_P1.3mm_Open_RoundedPad1.0x1.5mm
JP6: CAN termination; SolderJumper-2_P1.3mm_Open_RoundedPad1.0x1.5mm
JP7: SD CS on D3; SolderJumper-2_P1.3mm_Bridged_RoundedPad1.0x1.5mm
JP8: U3 3V3; SolderJumper-2_P1.3mm_Bridged_RoundedPad1.0x1.5mm
JP9: U3 RXD to D0; SolderJumper-2_P1.3mm_Bridged_RoundedPad1.0x1.5mm
JP10: U3 TXD to D1; SolderJumper-2_P1.3mm_Bridged_RoundedPad1.0x1.5mm
L1: 15uH; L_Changjiang_FNR4020S; MPN FNR4020S150MT
R1, R2: 4.7k; R_0402_1005Metric; MPN RC0402FR-074K7L
R3: 120k; R_0402_1005Metric; MPN RC0402FR-07120KL
R4: 22.1k; R_0402_1005Metric; MPN RC0402FR-0722K1L
R5: 120; R_0402_1005Metric; MPN RC0402FR-07120RL
R6, R9, R10, R11, R12: 10k; R_0402_1005Metric; MPN RC0402FR-0710KL
TP1: LED_R (D2); TestPoint_Pad_D1.5mm
TP2: LED_B (D3); TestPoint_Pad_D1.5mm
TP3: SDA; TestPoint_Pad_D1.0mm
TP4: SCL; TestPoint_Pad_D1.0mm
TP5: SDA_PU; TestPoint_Pad_D1.0mm
TP6: SCL_PU; TestPoint_Pad_D1.0mm
TP7: SA0; TestPoint_Pad_D1.0mm
TP8, TP26: 3V3; TestPoint_Pad_D1.0mm
TP9: IMU_INT1; TestPoint_Pad_D1.0mm
TP10: IMU_INT2; TestPoint_Pad_D1.0mm
TP11, TP25: GND; TestPoint_Pad_D1.0mm
TP12: UART_TX; TestPoint_Pad_D1.0mm
TP13: UART_RX; TestPoint_Pad_D1.0mm
TP14: CANH; TestPoint_Pad_D1.0mm
TP15: CANL; TestPoint_Pad_D1.0mm
TP16: CAN_TX; TestPoint_Pad_D1.0mm
TP17: CAN_RX; TestPoint_Pad_D1.0mm
TP18: TERM; TestPoint_Pad_D1.0mm
TP19: 5V_CAN; TestPoint_Pad_D1.0mm
TP20: VIN_RAW; TestPoint_Pad_D1.0mm
TP21: VIN; TestPoint_Pad_D1.0mm
TP22: 5V_BUCK; TestPoint_Pad_D1.0mm
TP23: XIAO_5V; TestPoint_Pad_D1.0mm
TP24: CB; TestPoint_Pad_D1.0mm
TP27: SD_CS; TestPoint_Pad_D1.0mm
TP28: SD_SCK; TestPoint_Pad_D1.0mm
TP29: SD_MISO; TestPoint_Pad_D1.0mm
TP30: SD_MOSI; TestPoint_Pad_D1.0mm
TVS1: SMBJ30A; D_SMB; MPN SMBJ30A
U1: LSM6DSO; LGA-14_3x2.5mm_P0.5mm_LayoutBorder3x4y; MPN LSM6DSOTR
U2: LMR51606Y; SOT-23-6; MPN LMR51606YDBVR
U3: SN65HVD230; SOIC-8_3.9x4.9mm_P1.27mm; MPN SN65HVD230DR
U4: XIAO ESP32-C3/C6/S3; XIAO_ESP32_14P_SMD; MPN Seeed XIAO ESP32C3 113991054 (or C6 113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
U5: SD NAND 2Gb (256 MB); SD_NAND_LGA-8_8x6mm_P1.27mm; MPN ZDSD02GLGEAG

Connections:
/3V3: C1.1, C2.1, C3.1, C8.1, C9.1, J2.2, J6.2, JP3.1 (A), JP8.1 (A), R1.1, R2.1, R9.1, R10.1, R11.1, R12.1, TP8.1, TP26.1, U1.5 (VDDIO), U1.8 (VDD), U1.12 (CS), U4.12 (3V3), U5.8 (VCC)
/3V3_CAN: C7.1, JP8.2 (B), U3.3 (VCC)
/5V_BUCK: C5.1, D2.2 (A), L1.2, R3.1, TP22.1
/5V_CAN: D3.2 (A), J3.4, TP19.1
/CANH: J3.3, J4.4, R5.1, TP14.1, U3.7 (CANH)
/CANL: J3.2, J4.5, JP6.2 (B), TP15.1, U3.6 (CANL)
/CAN_RX: J6.8, JP9.1 (A), TP17.1, U4.1 (D0)
/CAN_RXD: JP9.2 (B), U3.4 (R)
/CAN_TX: J6.9, JP10.1 (A), TP16.1, U4.2 (D1)
/CAN_TXD: JP10.2 (B), U3.1 (D)
/CB: C6.1, TP24.1, U2.1 (CB)
/FB: R3.2, R4.1, U2.3 (FB)
/GND: C1.2, C2.2, C3.2, C4.2, C5.2, C7.2, C8.2, C9.2, H1.1, H2.1, J2.1, J3.1, J4.3, J5.6, J6.3, J6.10, J7.2, JP3.3 (B), R4.2, R6.2, TP11.1, TP25.1, TVS1.2 (A), U1.2 (SDx), U1.3 (SCx), U1.6 (GND), U1.7 (GND), U2.2 (GND), U3.2 (GND), U4.13 (GND), U4.16 (GND(C3/S3)), U4.18 (GND(C6)), U5.4 (VSS)
/IMU_INT1: JP4.1 (A), TP9.1, U1.4 (INT1)
/IMU_INT2: JP5.1 (A), TP10.1, U1.9 (INT2)
/LED_B: J6.5, JP5.2 (B), JP7.1 (A), TP2.1, U4.4 (D3)
/LED_R: J6.4, JP4.2 (B), TP1.1, U4.3 (D2)
/RS: R6.1, U3.8 (Rs)
/SA0: JP3.2 (C), TP7.1, U1.1 (SDO/SA0)
/SCL: J2.4, J5.4, JP2.1 (A), TP4.1, U1.13 (SCL), U4.6 (D5/SCL)
/SCL_PU: JP2.2 (B), R2.2, TP6.1
/SDA: J2.3, J5.5, JP1.1 (A), TP3.1, U1.14 (SDA), U4.5 (D4/SDA)
/SDA_PU: JP1.2 (B), R1.2, TP5.1
/SD_CS: JP7.2 (B), R9.2, TP27.1, U5.2 (~CS)
/SD_MISO: R11.2, TP29.1, U4.10 (D9), U5.6 (DO)
/SD_MOSI: R12.2, TP30.1, U4.11 (D10), U5.5 (DI)
/SD_SCK: R10.2, TP28.1, U4.9 (D8), U5.3 (SCLK)
/SW: C6.2, L1.1, U2.6 (SW)
/TERM: JP6.1 (A), R5.2, TP18.1
/UART_RX: J5.3, J6.7, TP13.1, U4.8 (D7/RX)
/UART_TX: J5.2, J6.6, TP12.1, U4.7 (D6/TX)
/VBAT: J7.1, U4.15 (VBAT(C3/S3)), U4.17 (VBAT(C6))
/VIN: C4.1, D1.1 (K), TP21.1, TVS1.1 (K), U2.4 (EN), U2.5 (VIN)
/VIN_FUSED: D1.2 (A), F1.2
/VIN_RAW: F1.1, J4.2, TP20.1
/XIAO_5V: D2.1 (K), D3.1 (K), J5.1, J6.1, TP23.1, U4.14 (5V)

Notes on the sheet:
Power: NMEA 2000 NET-S or a 5-30 V lead on the J4 pads -> fuse -> reverse diode -> TVS -> LMR51606 buck 5 V -> diode-OR into the XIAO 5V pin
IMU: LSM6DSO on I2C, address 0x6B by default (JP3), as on the Takuma node
Controller: Seeed XIAO ESP32-C3 / C6 / S3 (pads 1-14 are common to all three)
GNSS: 6-pin JST-GH, Pixhawk GPS pinout, UART on D6/D7 + the I2C bus. DNP: fit by hand where wanted
Test pads (rev B): one per layer-crossing net, bottom side, 2.54 mm grid
CAN: SN65HVD230 on D0 (RX) / D1 (TX), the VESC Express pins. J3 VESC, J4 NMEA 2000. JP6 termination open. JP8/9/10 bridged: cut all three for a build with no CAN
IO header J6: 10-pin JST-GH, the spare pins on a lead (D0/D1 free once JP8-10 are cut)
BAT: 1S LiPo to the XIAO's own charger (carrier pads under the module)
Log storage: SD NAND on SPI, under the XIAO
Mechanical: M2 holes at the bow end

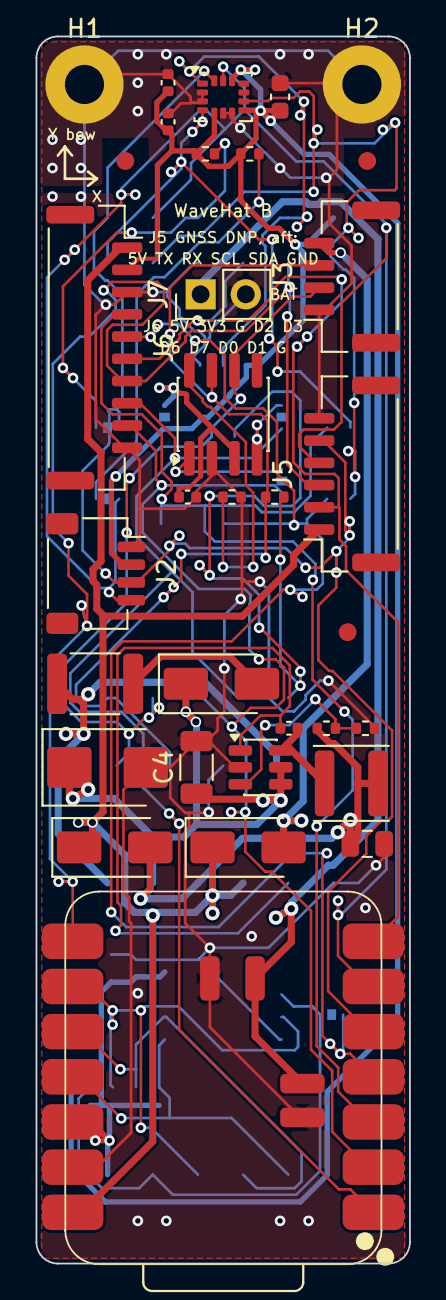
[picture p33: board hardware/kicad-revB/wavehat.kicad_pcb from above]

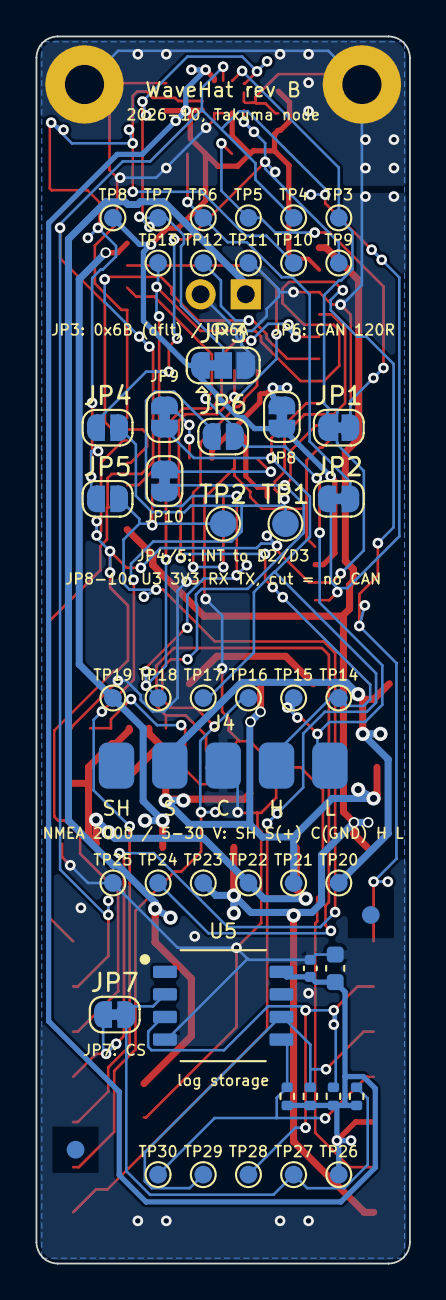
[picture p34: board hardware/kicad-revB/wavehat.kicad_pcb from below]

Board: 2 copper layers, 21.0 x 69.0 mm, 83 parts (50 on the bottom side), 36 nets.
