jb69/WaveHat/(commit log)

2026-11-09 WaveHat: sea-state sensor for Signal K on a Seeed XIAO
    Hardware (rev A and rev B KiCad projects, generators, order packs, test
    jig), enclosure, SensESP firmware with the wave maths and its tests,
    VESC Express board files, and the signalk-seastate plugin.
    [bom-revB.csv, bom.csv, results.csv, test_plate_points.scad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]
2026-11-09 docs: where to mount it, monohull and catamaran
2026-11-09 docs: rev A boards are in service in eFoils, not only on the bench
