jb69/WaveHat/(notices)

Notices in the files:
firmware/vesc_express/hw_wavehat_c6.h:
The VESC firmware is free software: you can redistribute it and/or modify
it under the terms of the GNU General Public License as published by
the Free Software Foundation, either version 3 of the License, or
(at your option) any later version.
parts and their libraries:
Seeed XIAO ESP32-C3/C6/S3, castellated pads 1-14 only. Derived from Seeed-Studio/OPL_Kicad_Library XIAO-ESP32-C3-SMD (CC BY-SA 4.0); pads 15+ removed so one footprint fits all three variants. Keep the area under the module free of exposed copper.
